emfcamp/Mk2-Hardware/README.md

Hardware
========

Hardware for the TiLDA v2 Badge
