emfcamp/Mk2-Hardware/TiLDA Mk2 Prototype v0.333 Schematic.pdf

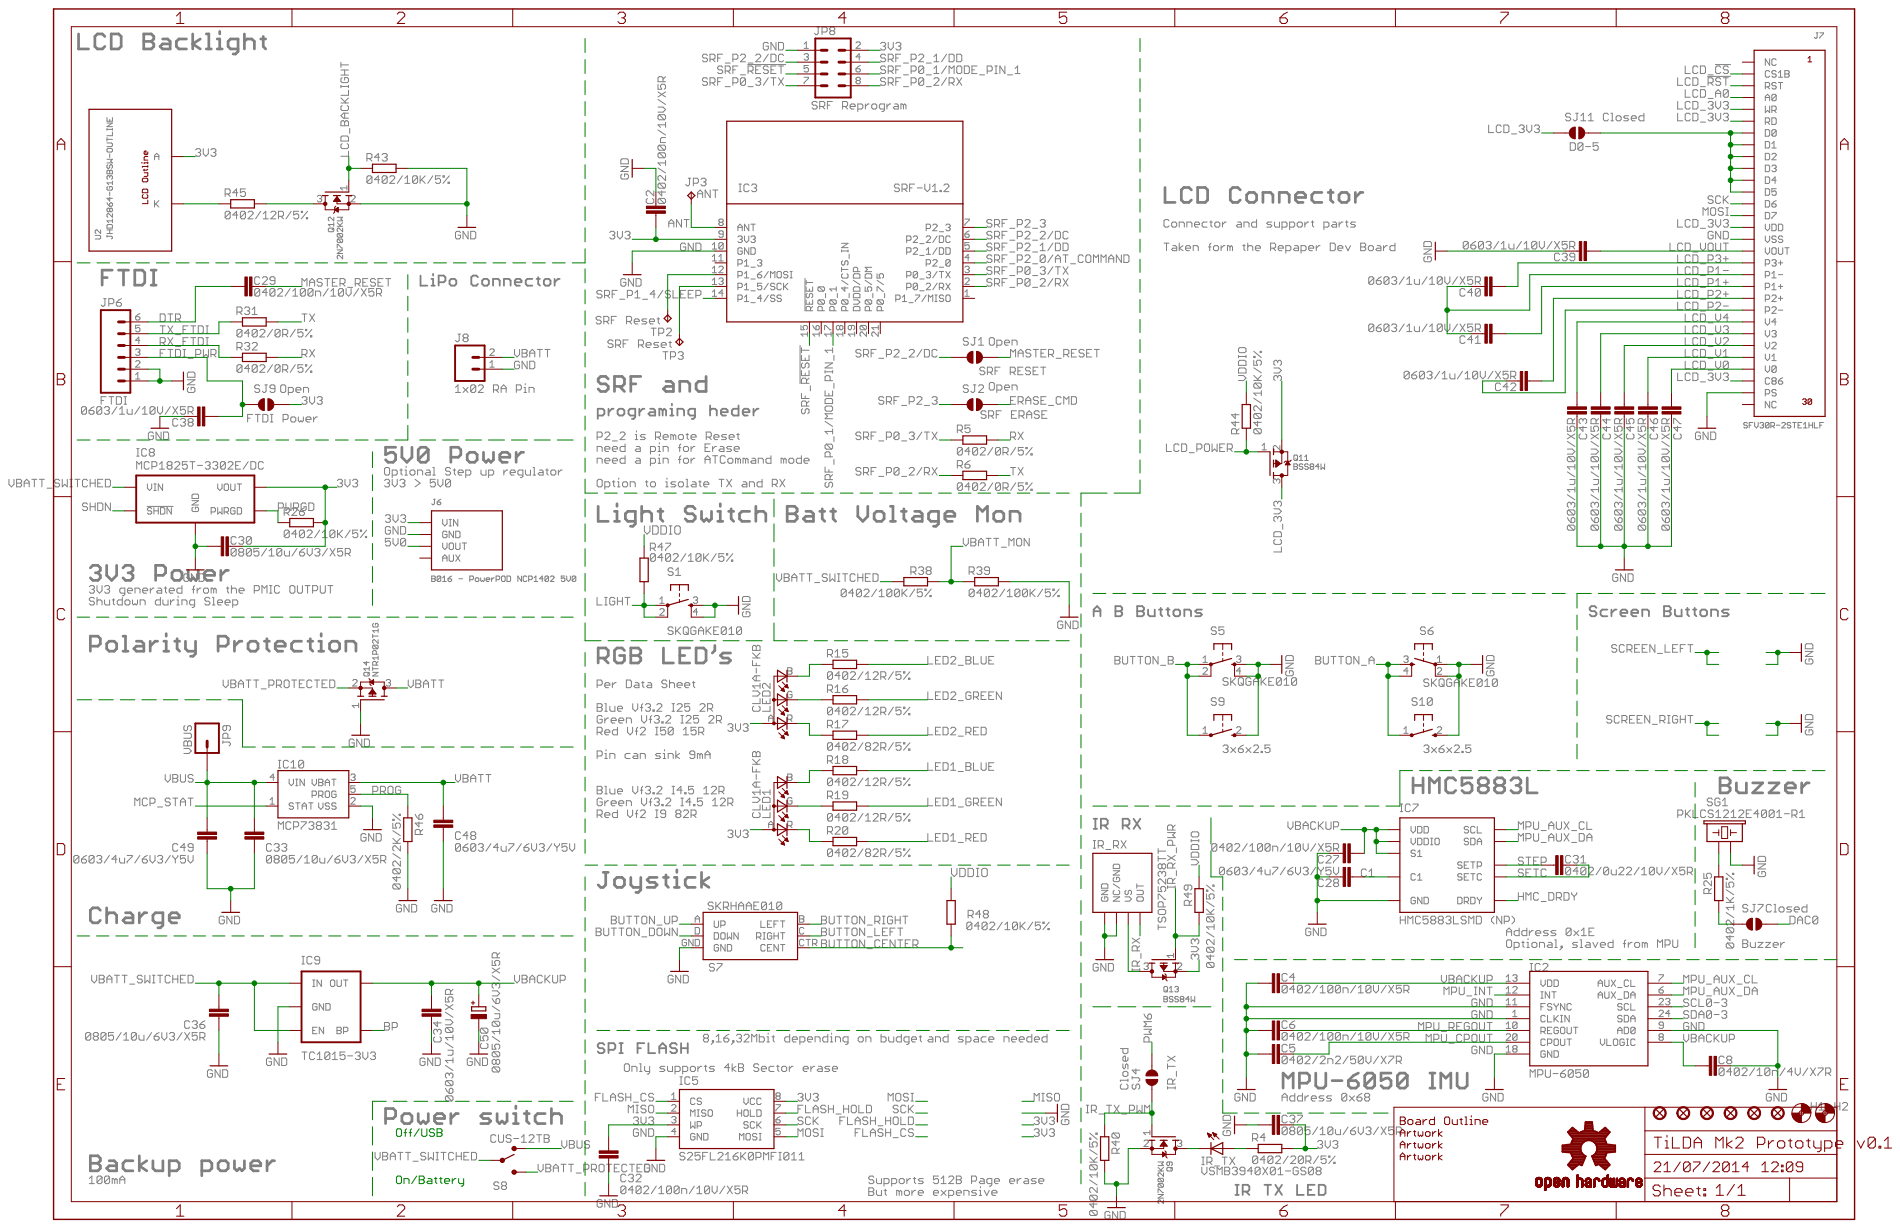
[picture p1: page 1]

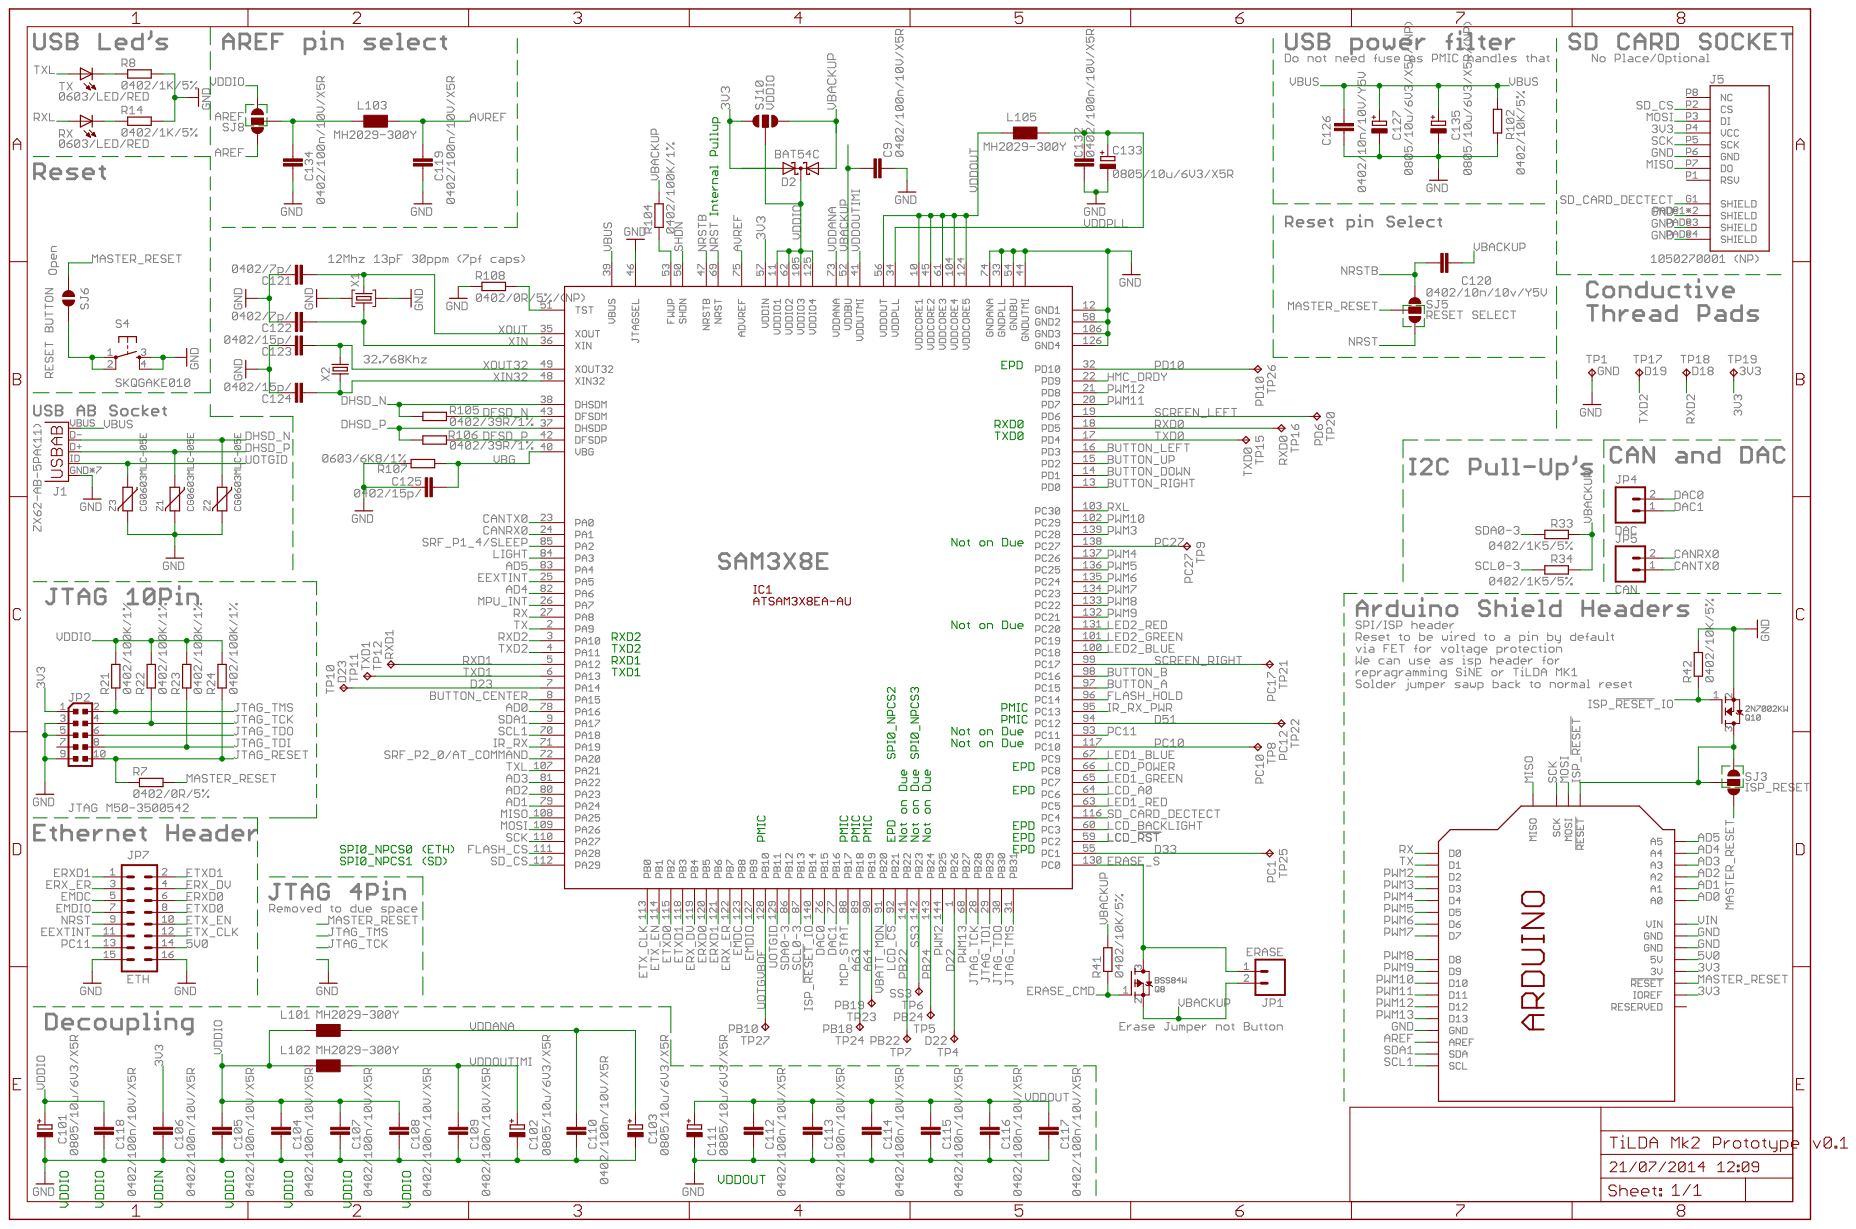
[picture p2: page 2]

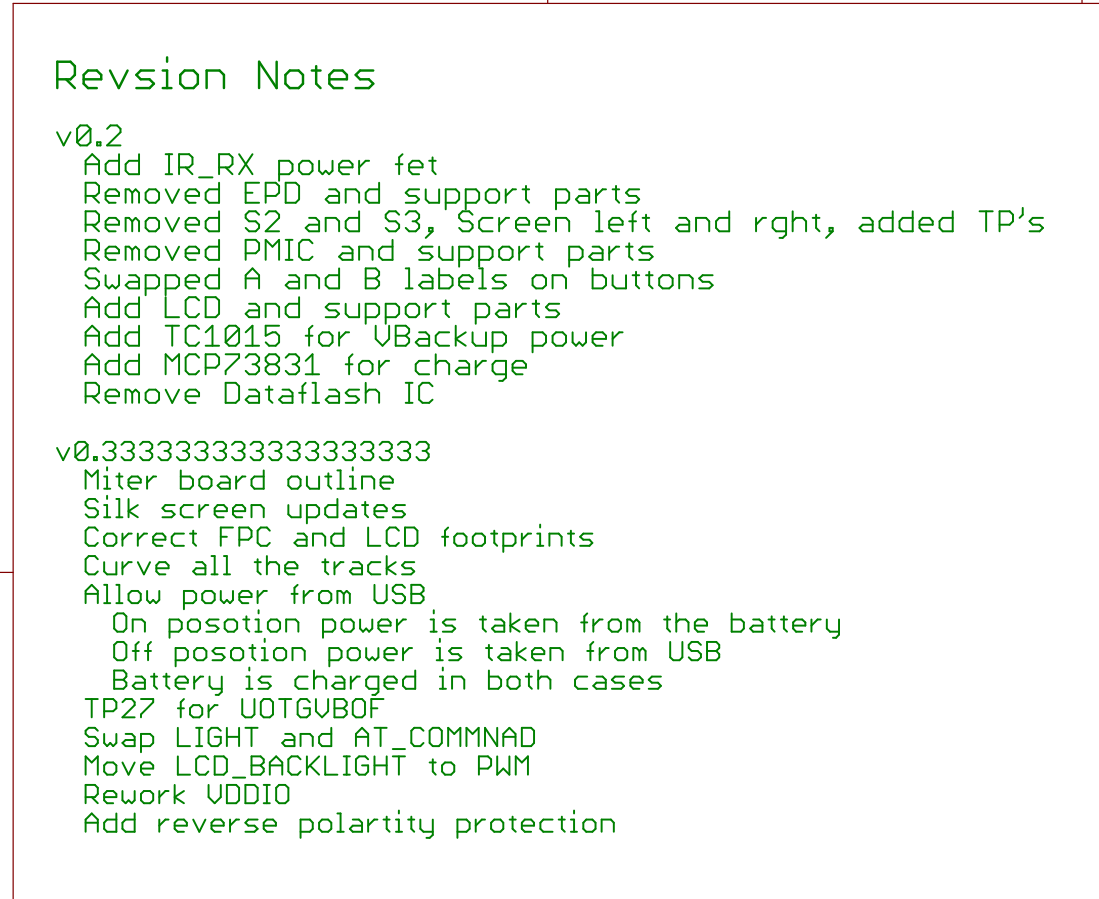
[picture p3: page 3]
