emfcamp/Mk2-Hardware/TiLDA Mk2 Prototype v0.2 Schematic.pdf

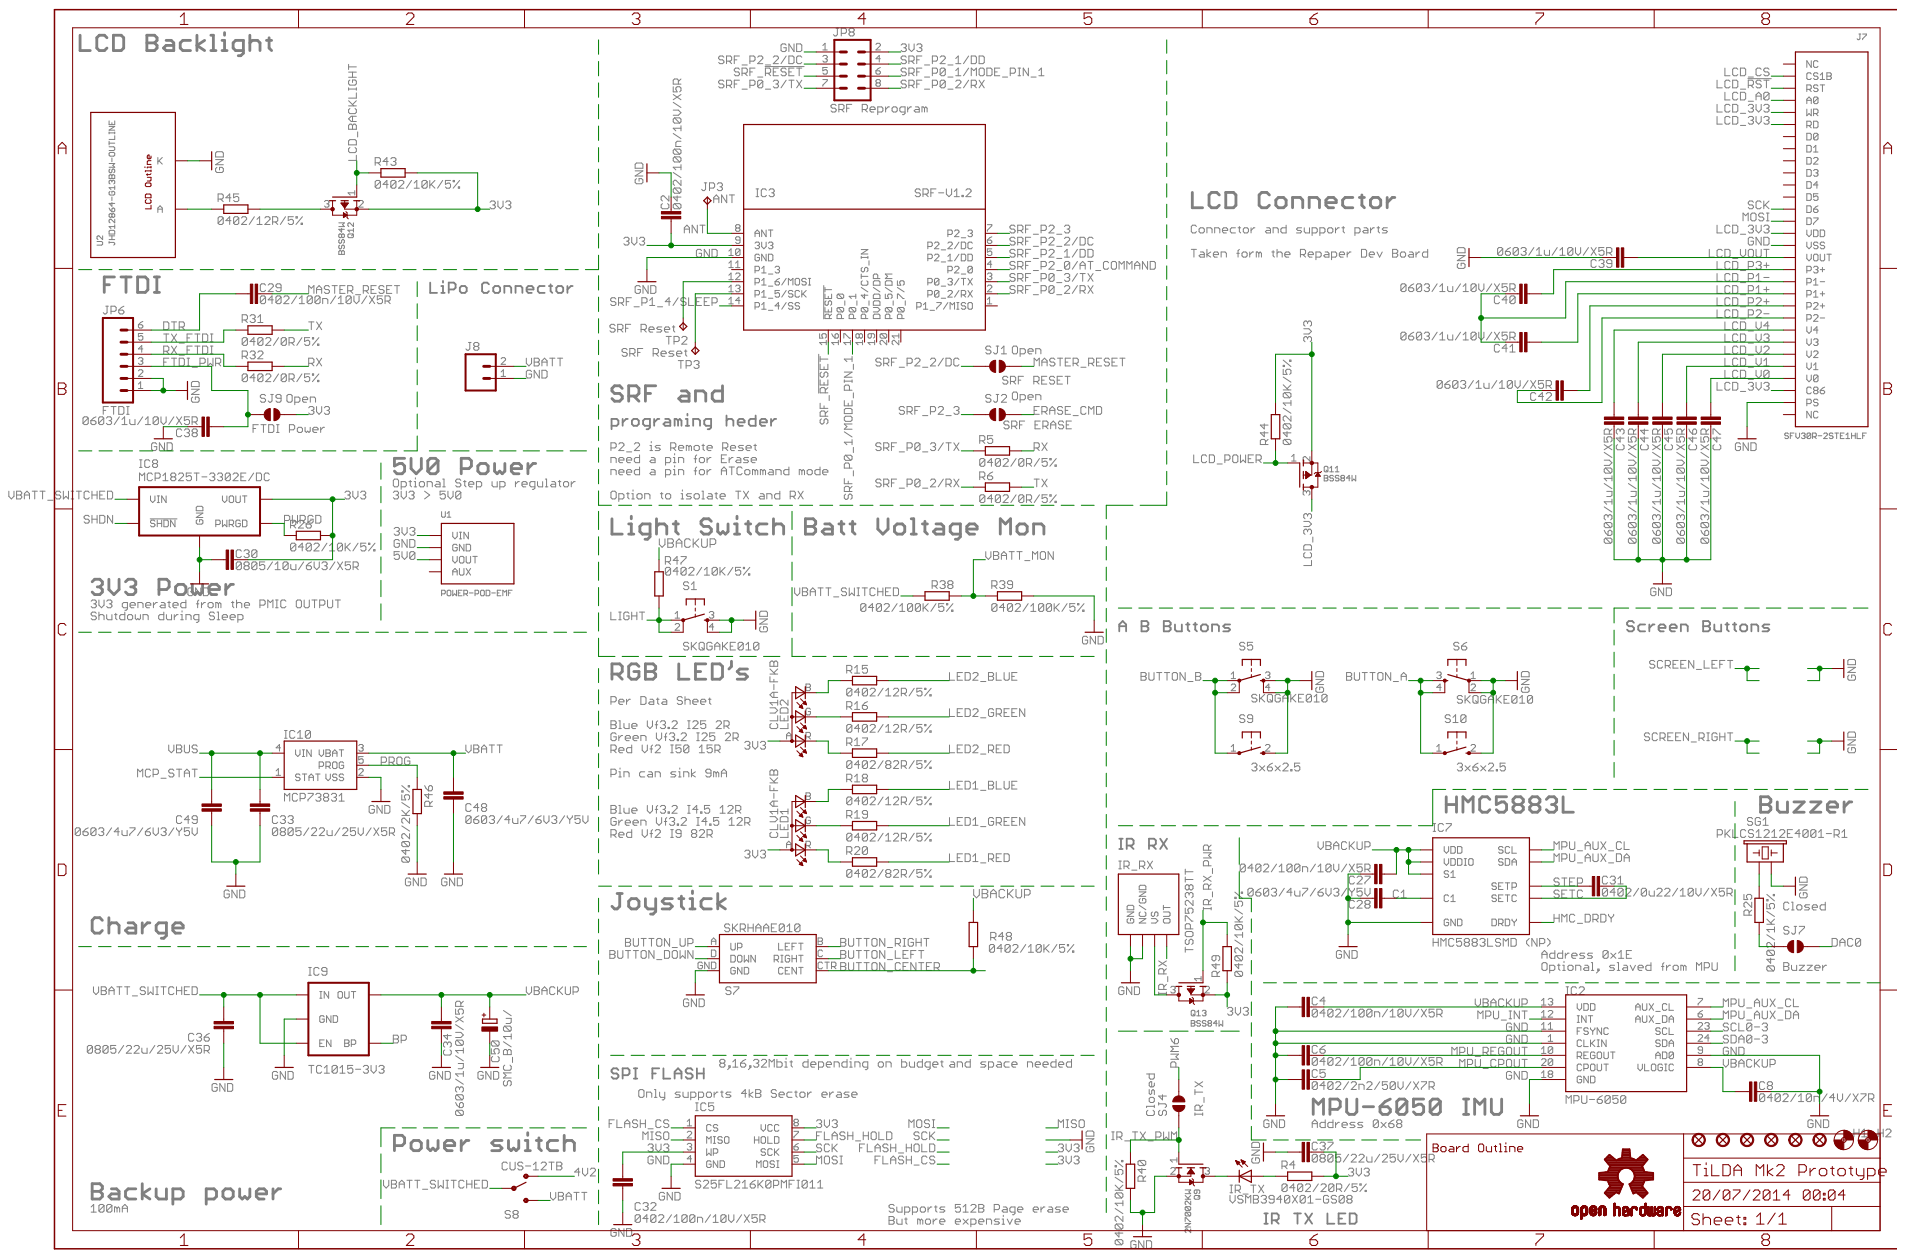
[picture p4: page 1]

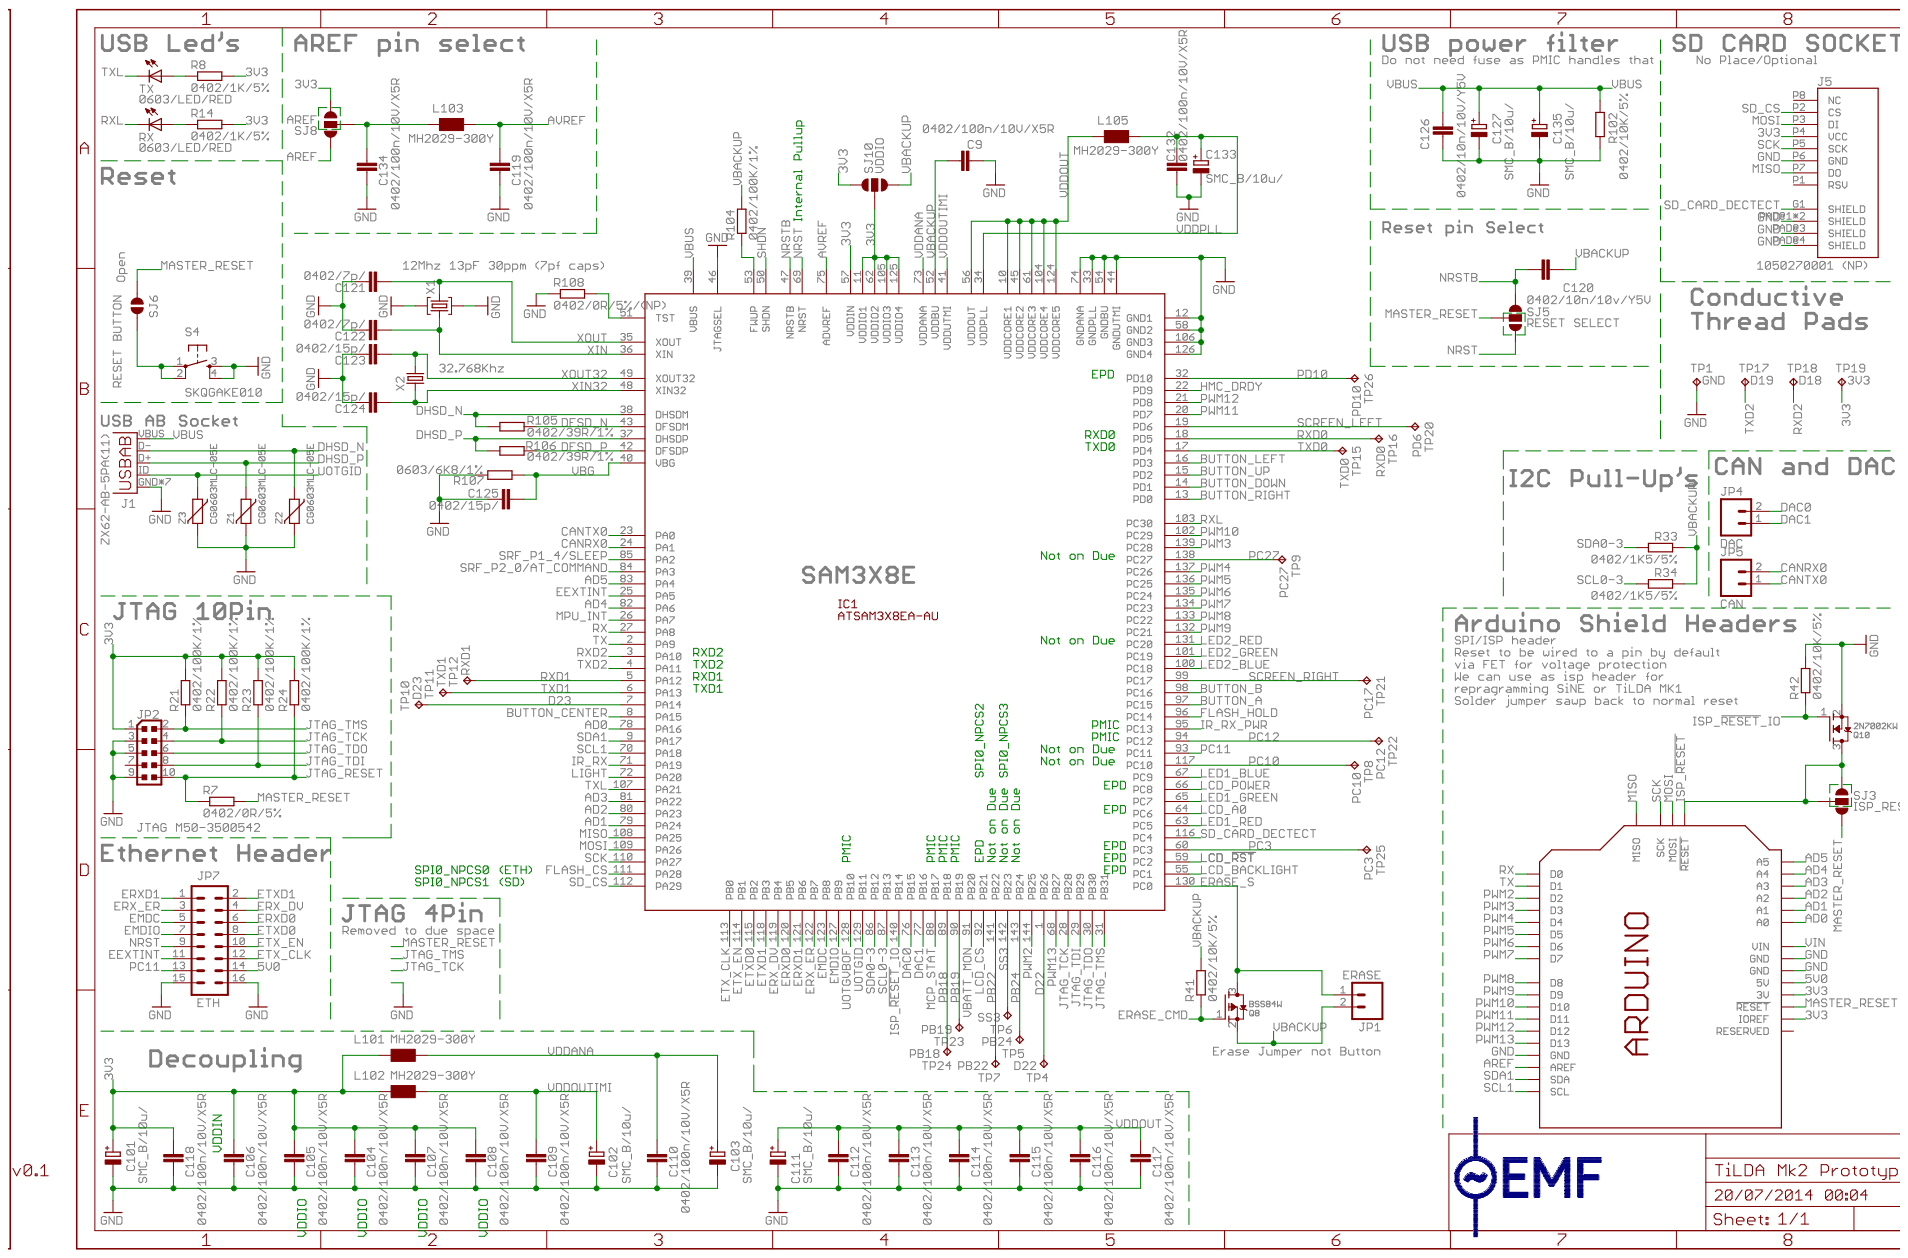
[picture p5: page 2]

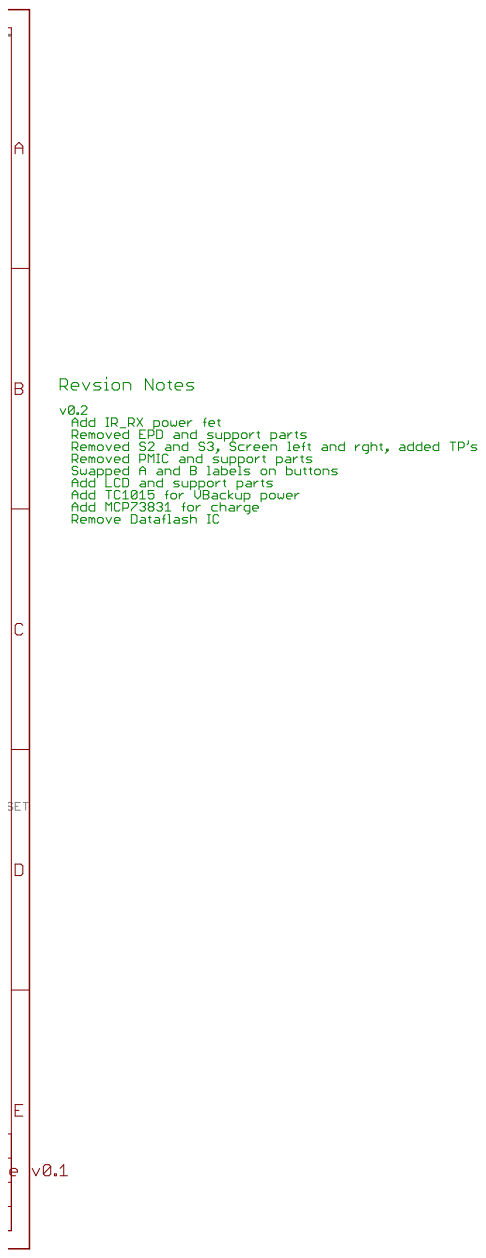
[picture p6: page 3]
