emfcamp/Mk2-Hardware/TiLDA Mk2 Prototype v0.1 Schematic.pdf

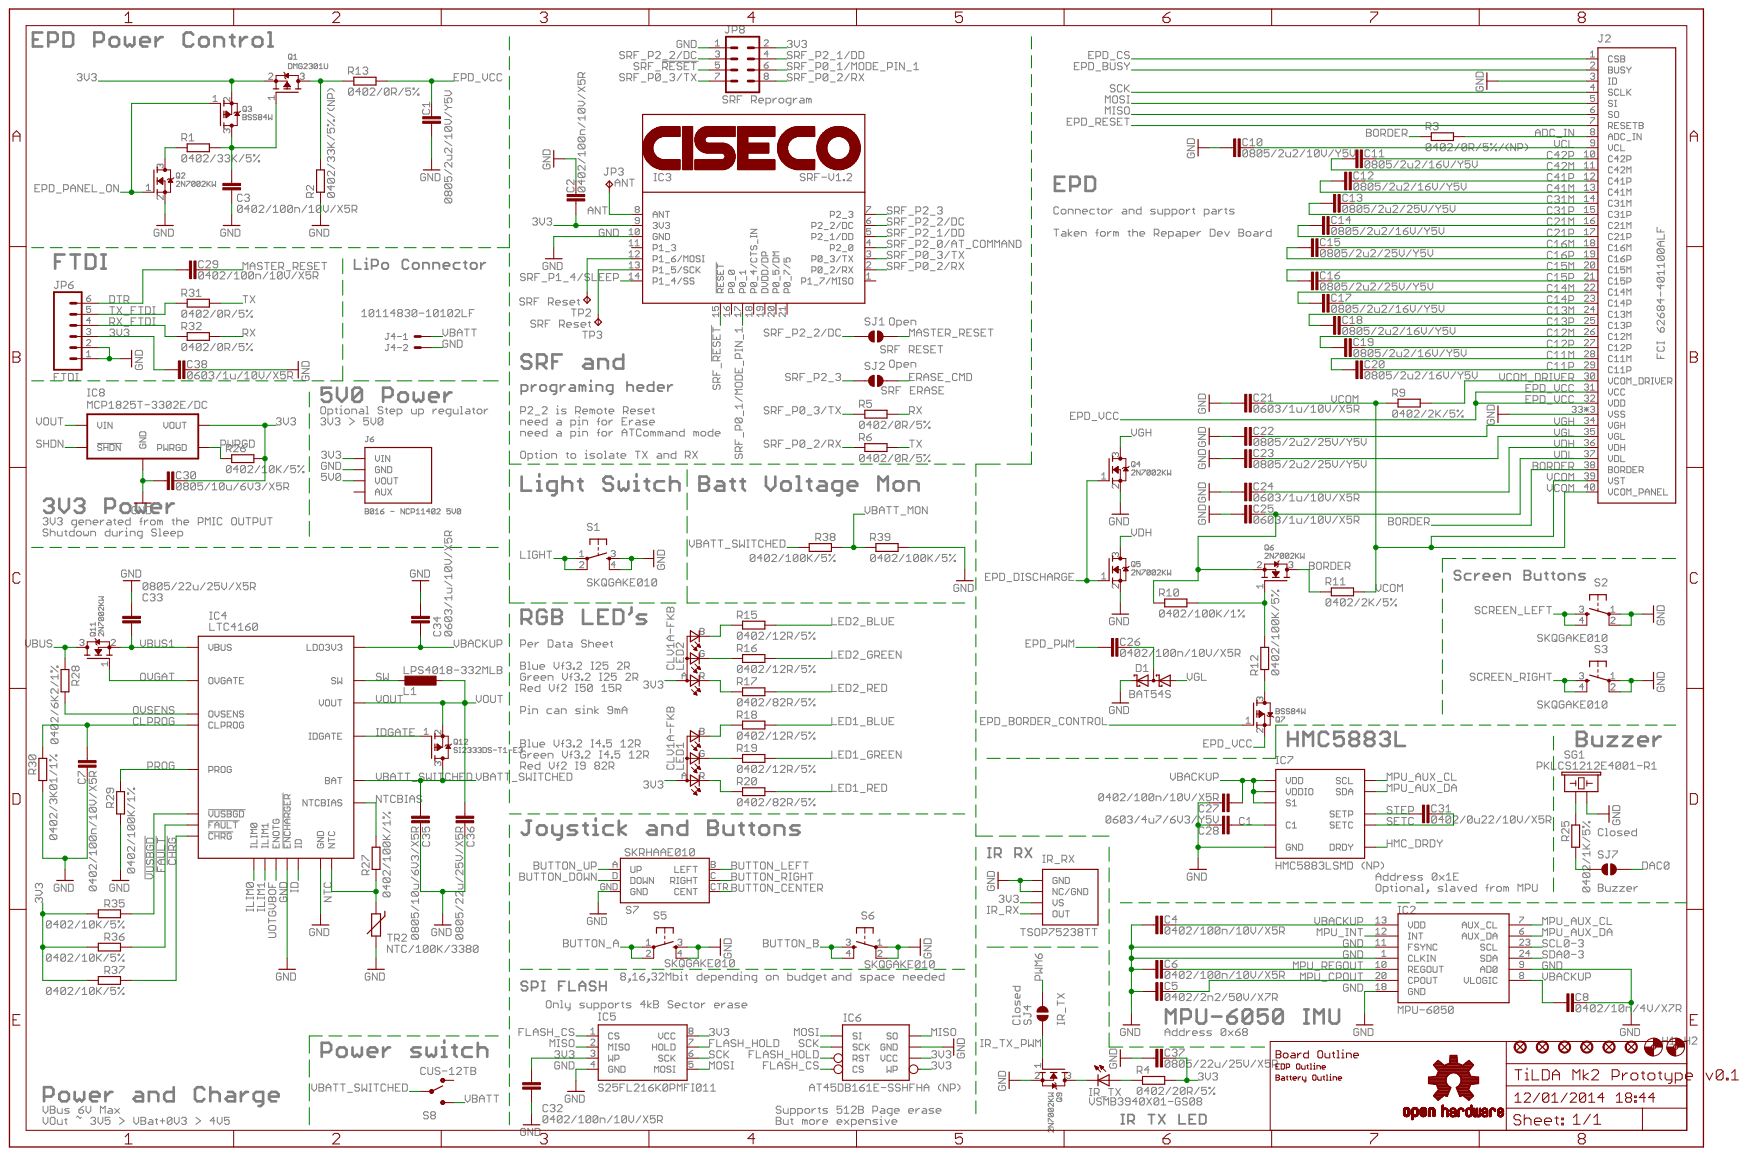
[picture p7: page 1]

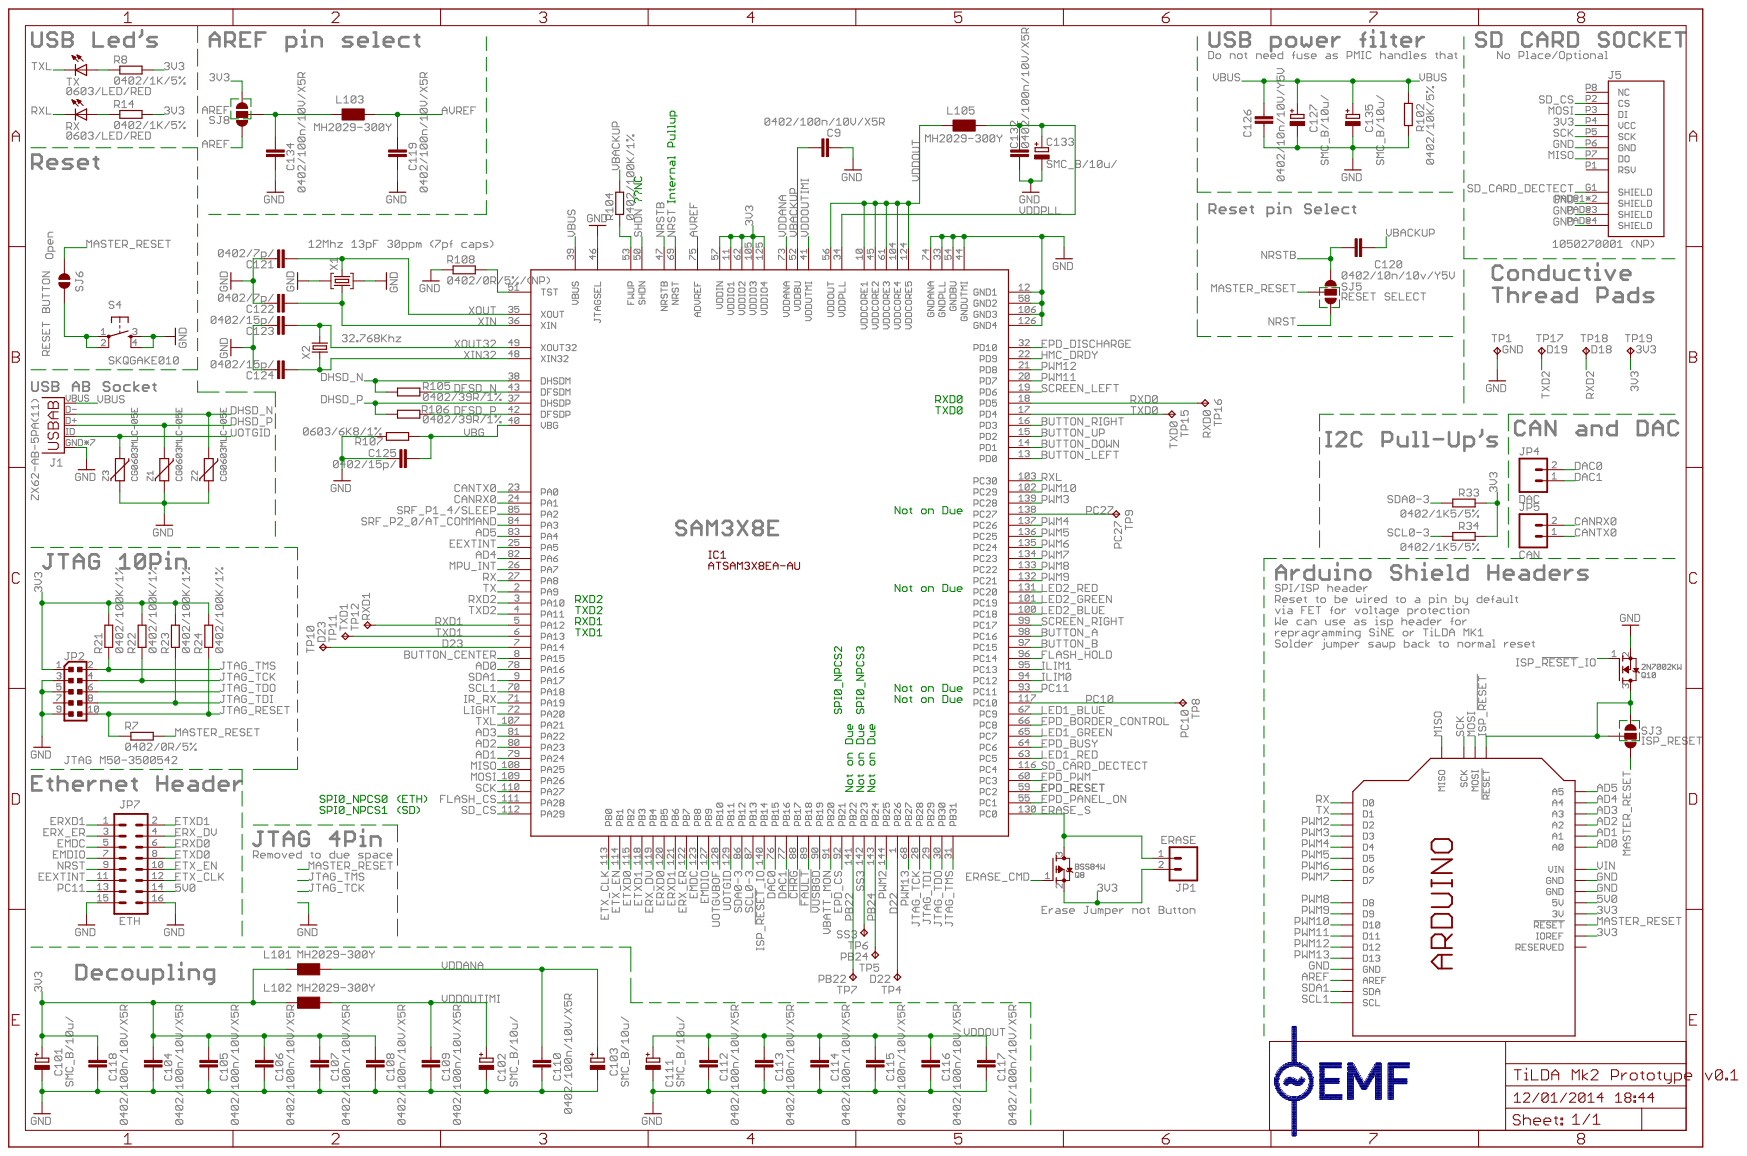
[picture p8: page 2]
