emfcamp/Mk2-Hardware/TiLDA Mk2 Prototype v0.333.pdf

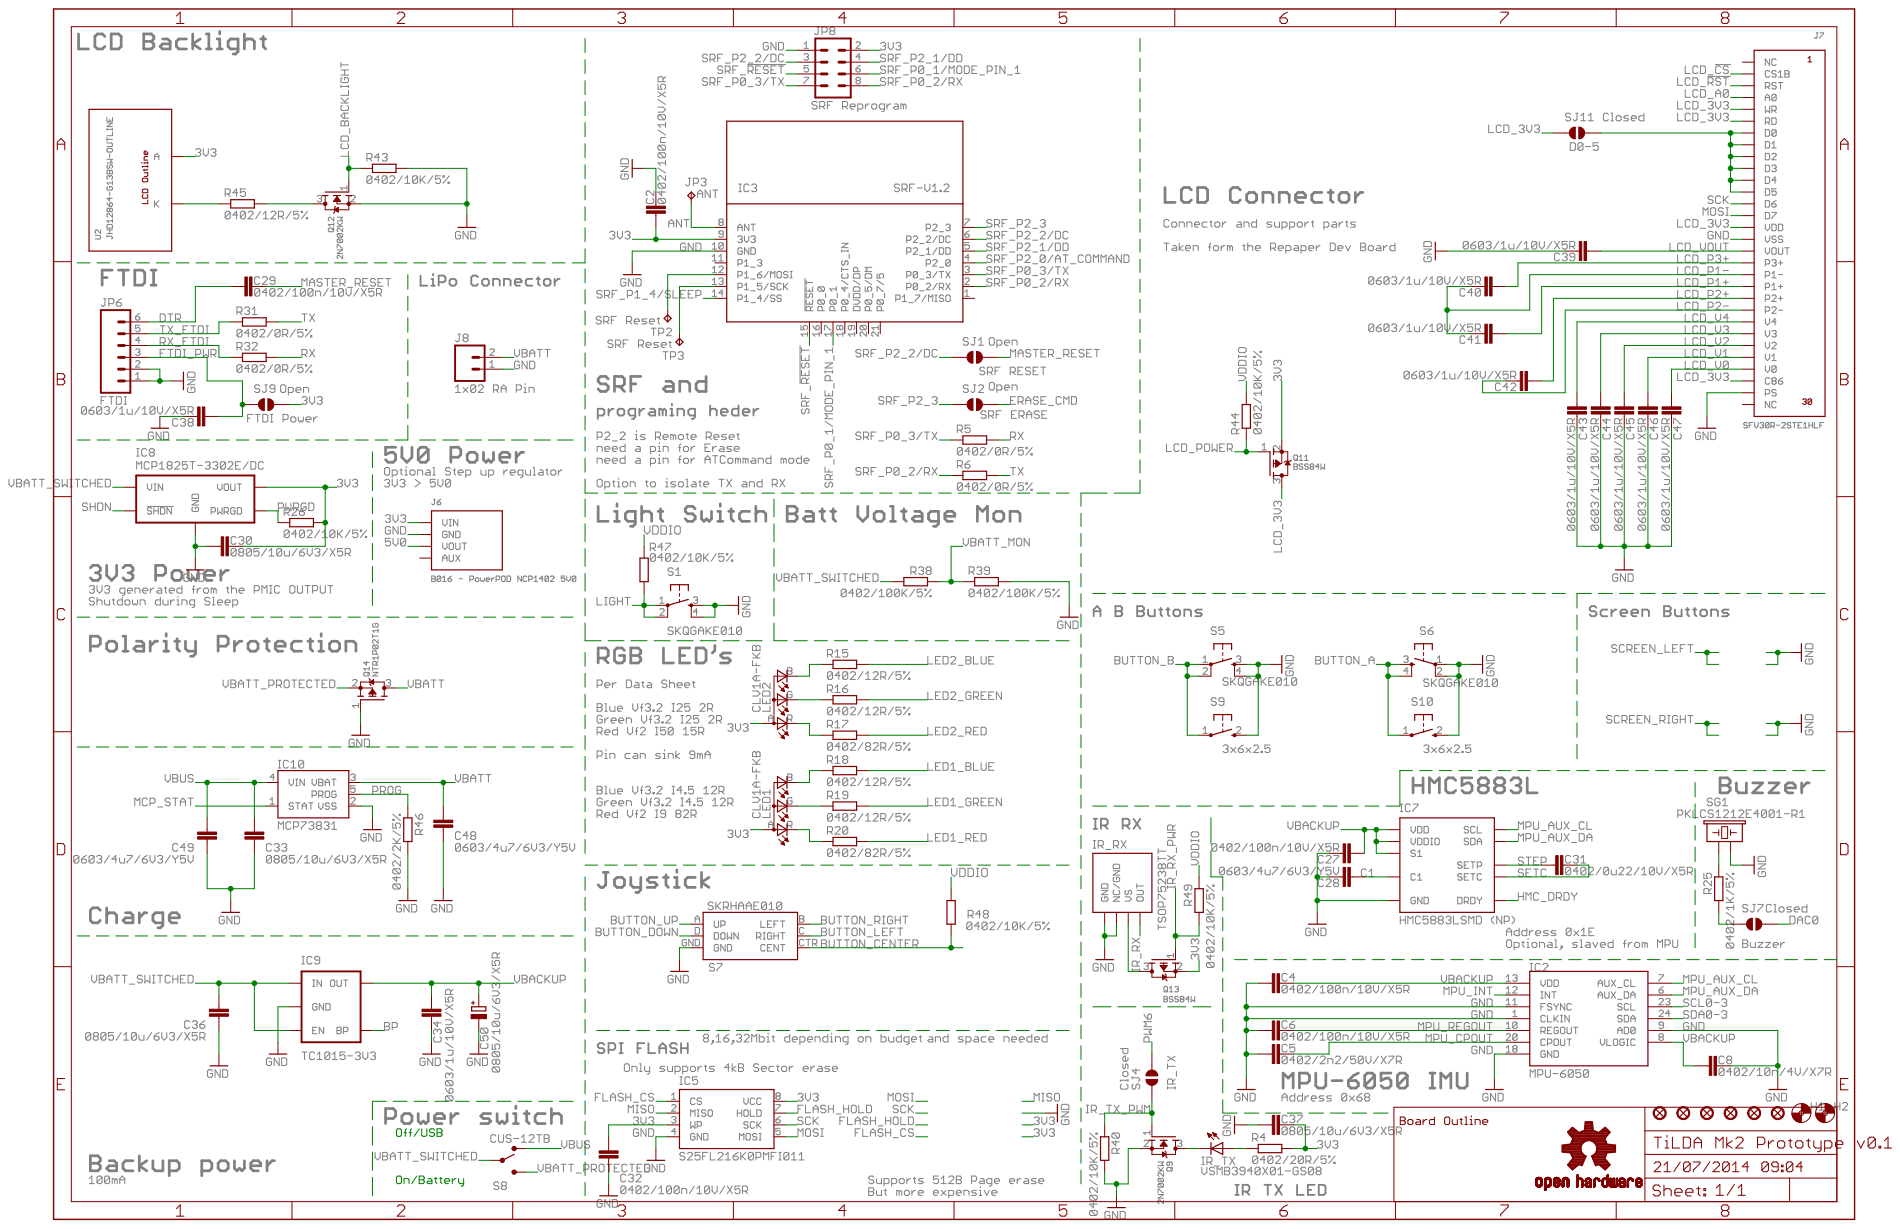
[picture p9: page 1]

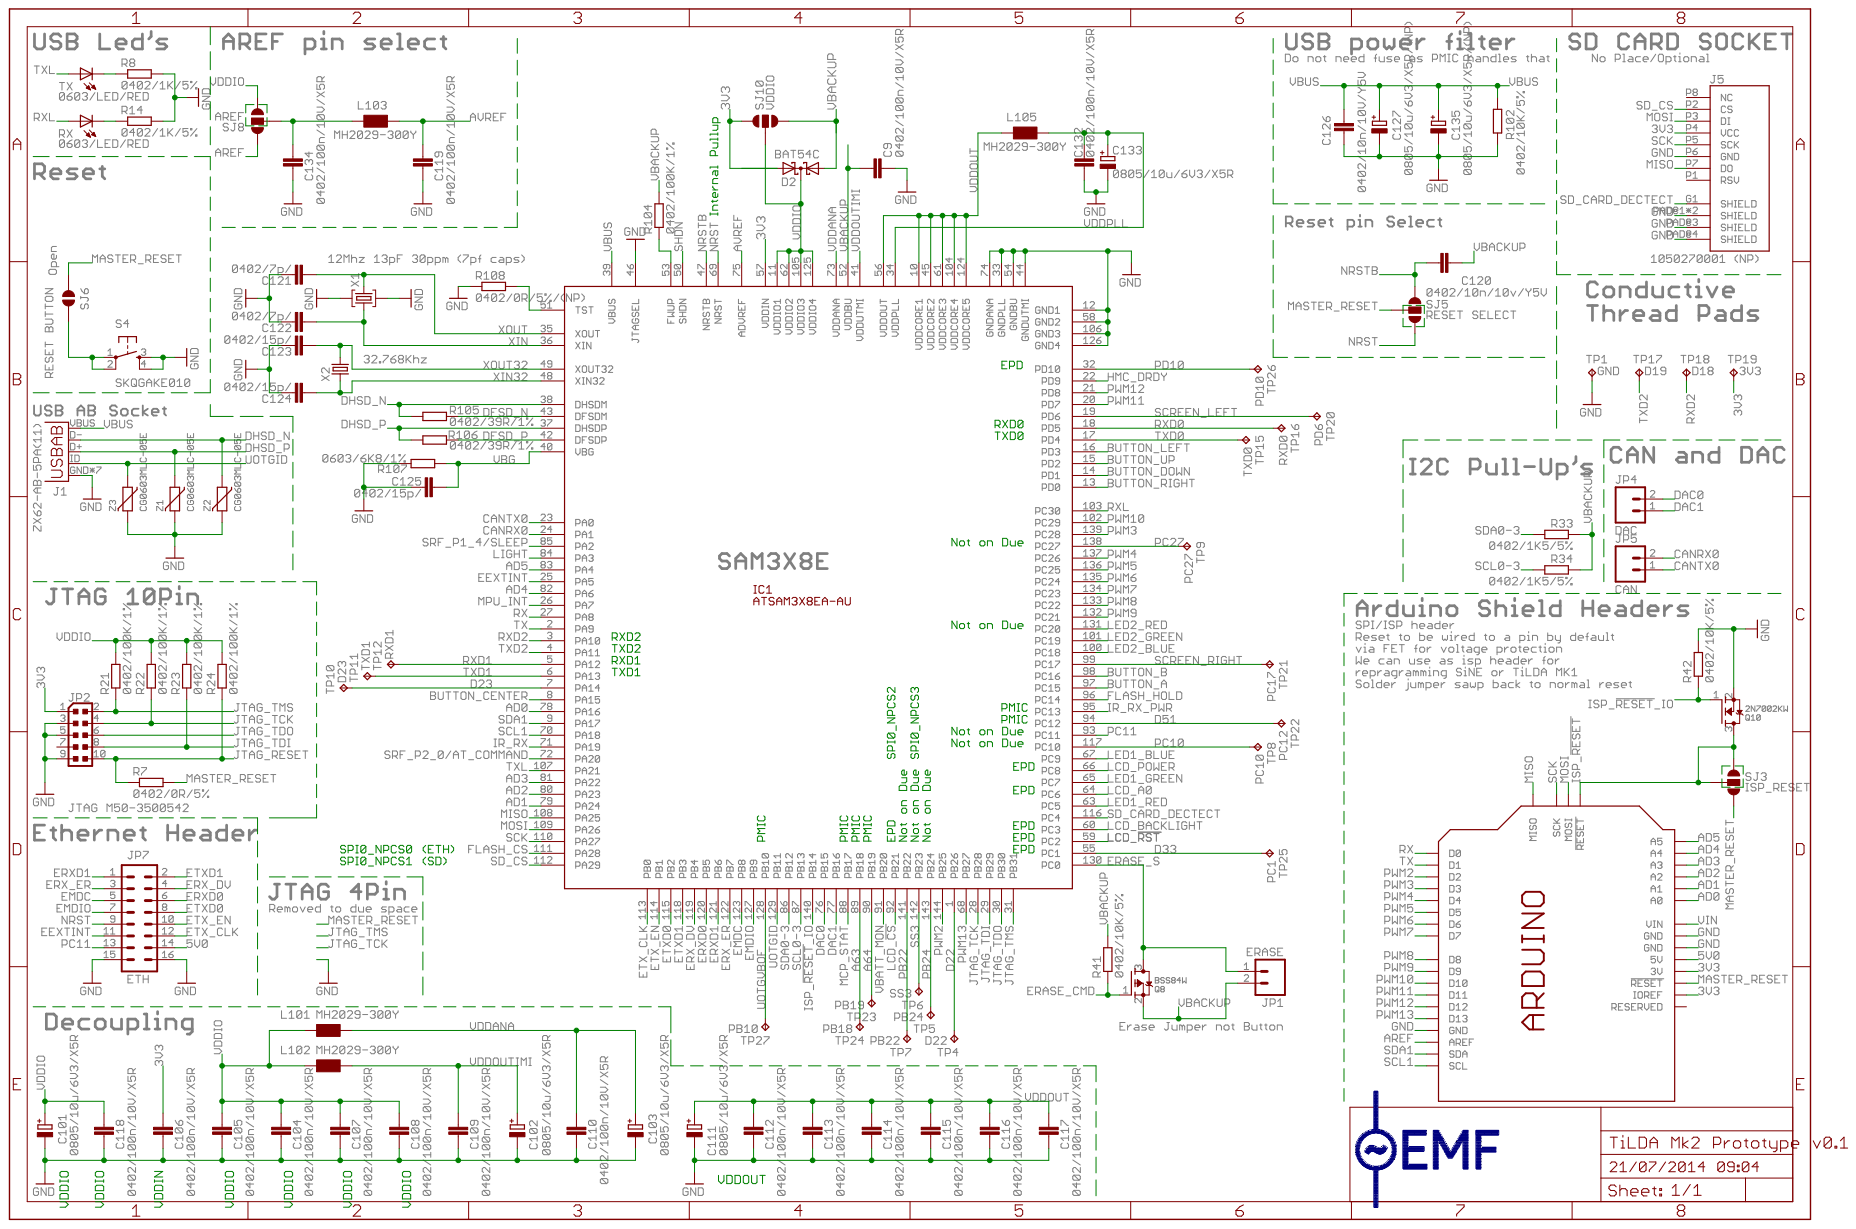
[picture p10: page 2]
