emfcamp/Mk2-Hardware/TiLDA Mk2 ProtoShield v0.1.brd

## EAGLE design TiLDA Mk2 ProtoShield v0.1.brd (2015-05-13)

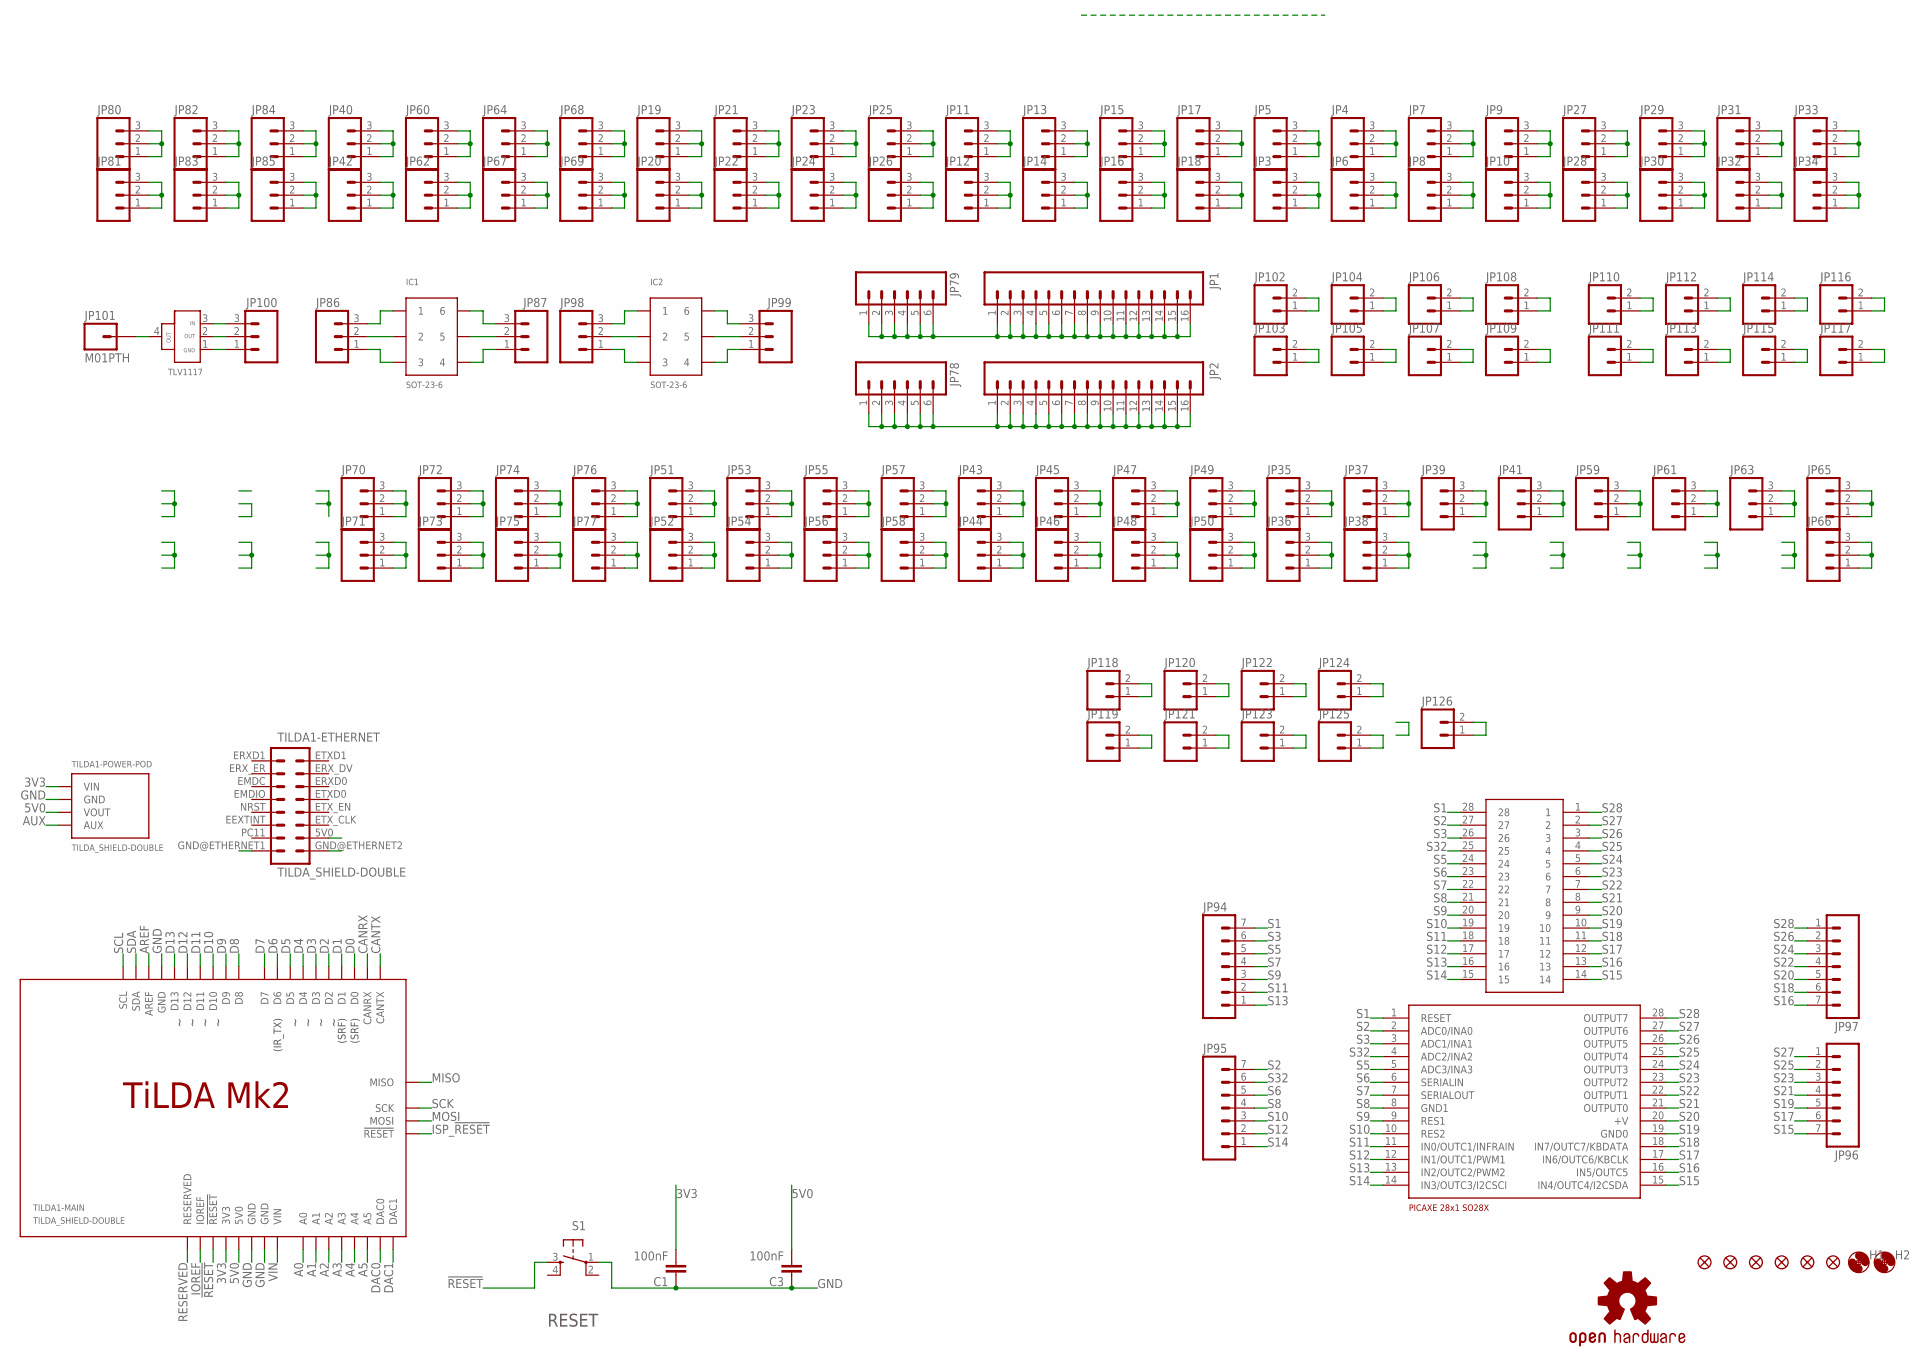
[picture p11: schematic TiLDA Mk2 ProtoShield v0.1.sch]

Parts:
C1, C3: 100nF; C025-024X044
FID1, FID2, FID3, FID4, FID5, FID6: FIDUCIAL1X2.5-STOP; FIDUCIAL-1X2.5-STOP
H1, H2: MOUNT-HOLE4.5-LWK; 4,5-LWK
IC1, IC2: SOT-23-6
JP1, JP2: M16PROTO_SILK; 1X16_PROTO_SILK
JP3, JP4, JP5, JP6, JP7, JP8, JP9, JP10, JP11, JP12, JP13, JP14, JP15, JP16, JP17, JP18, JP19, JP20, JP21, JP22, JP23, JP24, JP25, JP26, JP27, JP28, JP29, JP30, JP31, JP32, JP33, JP34, JP35, JP36, JP37, JP38, JP39, JP40, JP41, JP42, JP43, JP44, JP45, JP46, JP47, JP48, JP49, JP50, JP51, JP52, JP53, JP54, JP55, JP56, JP57, JP58, JP59, JP60, JP61, JP62, JP63, JP64, JP65, JP66, JP67, JP68, JP69, JP70, JP71, JP72, JP73, JP74, JP75, JP76, JP77, JP80, JP81, JP82, JP83, JP84, JP85: M03PROTO_SILK; 1X03_PROTO_SILK
JP78, JP79: M06PROTO_SILK; 1X06_PROTO_SLIK
JP86, JP87, JP98, JP99, JP100: M03PTH; 1X03
JP94, JP95, JP96, JP97: M07; 1X07
JP101: M01PTH; 1X01
JP102, JP103, JP104, JP105, JP106, JP107, JP108, JP109, JP110, JP111, JP112, JP113, JP114, JP115, JP116, JP117, JP118, JP119, JP120, JP121, JP122, JP123, JP124, JP125, JP126: M02PROTO_SILK; 1X02_PROTO_SILK
LOGO1: OSHW-LOGOM; OSHW-LOGO-M
LOGO2: EMFLOGO-2014-BOTH; EMFLOGO4
S1: TAC_SWITCHPTH; TACTILE-PTH
TILDA1: TILDA_SHIELD-DOUBLE; TILDA_SHIELD_DOUBLE
U$1: TLV1117-33CDCY; SOT223
U$2: SSOP28-NOSLIK; SSOP28D-NOSILK
U$5: PICAXE-28X1-SO28-MULITWIDE; S028-MUTLIWIDE

Connections:
3V3: C1.2, TILDA1.3V3@1 (3V3), TILDA1.3V3@2 (3V3), TILDA1.3V3@POD (VIN), TILDA1.3V3@POD1 (VIN)
5V0: C3.2, TILDA1.5V (5V0), TILDA1.5V0 (14), TILDA1.5V0@1 (5V0), TILDA1.5V0@POD (VOUT), TILDA1.5V0@POD1 (VOUT), TILDA1.5V@ISP (5V0), TILDA1.5V@ISP@1 (5V0)
!RESET: S1.3, TILDA1.!RESET, TILDA1.!RESET@1 (!RESET)
A0: TILDA1.A0, TILDA1.A0@1 (A0)
A1: TILDA1.A1, TILDA1.A1@1 (A1)
A2: TILDA1.A2, TILDA1.A2@1 (A2)
A3: TILDA1.A3, TILDA1.A3@1 (A3)
A4: TILDA1.A4, TILDA1.A4@1 (A4)
A5: TILDA1.A5, TILDA1.A5@1 (A5)
AREF: TILDA1.AREF, TILDA1.AREF@1 (AREF)
AUX: TILDA1.AUX@POD (AUX), TILDA1.AUX@POD1 (AUX)
CANRX: TILDA1.CANRX, TILDA1.CANRX@1 (CANRX)
CANTX: TILDA1.CANTX, TILDA1.CANTX@1 (CANTX)
D0: TILDA1.D0, TILDA1.D0@1 (D0)
D1: TILDA1.D1, TILDA1.D1@1 (D1)
D2: TILDA1.D2, TILDA1.D2@1 (D2)
D3: TILDA1.D3, TILDA1.D3@1 (D3)
D4: TILDA1.D4, TILDA1.D4@1 (D4)
D5: TILDA1.D5, TILDA1.D5@1 (D5)
D6: TILDA1.D6, TILDA1.D6@1 (D6)
D7: TILDA1.D7, TILDA1.D7@1 (D7)
D8: TILDA1.D8, TILDA1.D8@1 (D8)
D9: TILDA1.D9, TILDA1.D9@1 (D9)
D10: TILDA1.D10, TILDA1.D10@1 (D10)
D11: TILDA1.D11, TILDA1.D11@1 (D11)
D12: TILDA1.D12, TILDA1.D12@1 (D12)
D13: TILDA1.D13, TILDA1.D13@1 (D13)
DAC0: TILDA1.DAC0, TILDA1.DAC0@1 (DAC0)
DAC1: TILDA1.DAC1, TILDA1.DAC1@1 (DAC1)
GND: C1.1, C3.1, S1.1, TILDA1.GND@1 (GND), TILDA1.GND@2 (GND), TILDA1.GND@3 (GND), TILDA1.GND@4 (GND), TILDA1.GND@5 (GND), TILDA1.GND@6 (GND), TILDA1.GND@ETHERNET1 (15), TILDA1.GND@ETHERNET2 (16), TILDA1.GND@ISP (GND), TILDA1.GND@ISP1 (GND), TILDA1.GND@POD (GND), TILDA1.GND@POD1 (GND)
IOREF: TILDA1.IOREF, TILDA1.IOREF@1 (IOREF)
ISP_!RESET: TILDA1.!RESET@ISP (!RESET), TILDA1.!RESET@ISP1 (!RESET)
MISO: TILDA1.MISO, TILDA1.MISO@1 (MISO)
MOSI: TILDA1.MOSI, TILDA1.MOSI@1 (MOSI)
unnamed: JP1.1, JP1.2, JP1.3, JP1.4, JP1.5, JP1.6, JP1.7, JP1.8, JP1.9, JP1.10, JP1.11, JP1.12, JP1.13, JP1.14, JP1.15, JP1.16, JP79.1, JP79.2, JP79.3, JP79.4, JP79.5, JP79.6
unnamed: JP2.1, JP2.2, JP2.3, JP2.4, JP2.5, JP2.6, JP2.7, JP2.8, JP2.9, JP2.10, JP2.11, JP2.12, JP2.13, JP2.14, JP2.15, JP2.16, JP78.1, JP78.2, JP78.3, JP78.4, JP78.5, JP78.6
unnamed: JP5.1, JP5.2, JP5.3
unnamed: JP3.1, JP3.2, JP3.3
unnamed: JP4.1, JP4.2, JP4.3
unnamed: JP6.1, JP6.2, JP6.3
unnamed: JP7.1, JP7.2, JP7.3
unnamed: JP8.1, JP8.2, JP8.3
unnamed: JP9.1, JP9.2, JP9.3
unnamed: JP10.1, JP10.2, JP10.3
unnamed: JP11.1, JP11.2, JP11.3
unnamed: JP12.1, JP12.2, JP12.3
unnamed: JP13.1, JP13.2, JP13.3
unnamed: JP14.1, JP14.2, JP14.3
unnamed: JP15.1, JP15.2, JP15.3
unnamed: JP16.1, JP16.2, JP16.3
unnamed: JP17.1, JP17.2, JP17.3
unnamed: JP18.1, JP18.2, JP18.3
unnamed: JP19.1, JP19.2, JP19.3
unnamed: JP20.1, JP20.2, JP20.3
unnamed: JP21.1, JP21.2, JP21.3
unnamed: JP22.1, JP22.2, JP22.3
unnamed: JP23.1, JP23.2, JP23.3
unnamed: JP24.1, JP24.2, JP24.3
unnamed: JP25.1, JP25.2, JP25.3
unnamed: JP26.1, JP26.2, JP26.3
unnamed: JP27.1, JP27.2, JP27.3
unnamed: JP28.1, JP28.2, JP28.3
unnamed: JP29.1, JP29.2, JP29.3
unnamed: JP30.1, JP30.2, JP30.3
unnamed: JP31.1, JP31.2, JP31.3
unnamed: JP32.1, JP32.2, JP32.3
unnamed: JP33.1, JP33.2, JP33.3
unnamed: JP34.1, JP34.2, JP34.3
unnamed: JP35.1, JP35.2, JP35.3
unnamed: JP36.1, JP36.2, JP36.3
unnamed: JP37.1, JP37.2, JP37.3
unnamed: JP38.1, JP38.2, JP38.3
unnamed: JP39.1, JP39.2, JP39.3
unnamed: JP41.1, JP41.2, JP41.3
unnamed: JP43.1, JP43.2, JP43.3
unnamed: JP44.1, JP44.2, JP44.3
unnamed: JP45.1, JP45.2, JP45.3
unnamed: JP46.1, JP46.2, JP46.3
unnamed: JP47.1, JP47.2, JP47.3
unnamed: JP48.1, JP48.2, JP48.3
unnamed: JP49.1, JP49.2, JP49.3
unnamed: JP50.1, JP50.2, JP50.3
unnamed: JP51.1, JP51.2, JP51.3
unnamed: JP52.1, JP52.2, JP52.3
unnamed: JP53.1, JP53.2, JP53.3
unnamed: JP54.1, JP54.2, JP54.3
unnamed: JP55.1, JP55.2, JP55.3
unnamed: JP56.1, JP56.2, JP56.3
unnamed: JP57.1, JP57.2, JP57.3
unnamed: JP58.1, JP58.2, JP58.3
unnamed: JP59.1, JP59.2, JP59.3
unnamed: JP61.1, JP61.2, JP61.3
unnamed: JP63.1, JP63.2, JP63.3
unnamed: JP65.1, JP65.2, JP65.3
unnamed: JP66.1, JP66.2, JP66.3
unnamed: JP40.1, JP40.2, JP40.3
unnamed: JP42.1, JP42.2, JP42.3
unnamed: JP60.1, JP60.2, JP60.3
unnamed: JP62.1, JP62.2, JP62.3
unnamed: JP64.1, JP64.2, JP64.3
unnamed: JP67.1, JP67.2, JP67.3
unnamed: JP68.1, JP68.2, JP68.3
unnamed: JP69.1, JP69.2, JP69.3
unnamed: JP70.1, JP70.2, JP70.3
unnamed: JP71.1, JP71.2, JP71.3
unnamed: JP72.1, JP72.2, JP72.3
unnamed: JP73.1, JP73.2, JP73.3
unnamed: JP74.1, JP74.2, JP74.3
unnamed: JP75.1, JP75.2, JP75.3
unnamed: JP76.1, JP76.2, JP76.3
unnamed: JP77.1, JP77.2, JP77.3
unnamed: IC1.2, JP86.2
unnamed: IC1.1, JP86.3
unnamed: JP80.1, JP80.2, JP80.3
unnamed: JP81.1, JP81.2, JP81.3
unnamed: JP82.1, JP82.2, JP82.3
unnamed: JP83.1, JP83.2, JP83.3
unnamed: JP84.1, JP84.2, JP84.3
unnamed: JP85.1, JP85.2, JP85.3
unnamed: IC1.3, JP86.1
unnamed: IC1.5, JP87.2
unnamed: IC1.6, JP87.3
unnamed: IC1.4, JP87.1
unnamed: IC2.2, JP98.2
unnamed: IC2.1, JP98.3
unnamed: IC2.3, JP98.1
unnamed: IC2.5, JP99.2
unnamed: IC2.6, JP99.3
unnamed: IC2.4, JP99.1
unnamed: JP100.1, U$1.1 (GND)
unnamed: JP100.2, U$1.2 (OUT1)
unnamed: JP100.3, U$1.3 (IN)
unnamed: JP101.1, U$1.4 (OUT2)
unnamed: JP102.1, JP102.2
unnamed: JP103.1, JP103.2
unnamed: JP104.1, JP104.2
unnamed: JP105.1, JP105.2
unnamed: JP106.1, JP106.2
unnamed: JP107.1, JP107.2
unnamed: JP108.1, JP108.2
unnamed: JP109.1, JP109.2
unnamed: JP110.1, JP110.2
unnamed: JP111.1, JP111.2
unnamed: JP112.1, JP112.2
unnamed: JP113.1, JP113.2
unnamed: JP114.1, JP114.2
unnamed: JP115.1, JP115.2
unnamed: JP116.1, JP116.2
unnamed: JP117.1, JP117.2
unnamed: JP118.1, JP118.2
unnamed: JP119.1, JP119.2
unnamed: JP120.1, JP120.2
unnamed: JP121.1, JP121.2
unnamed: JP122.1, JP122.2
unnamed: JP123.1, JP123.2
unnamed: JP124.1, JP124.2
unnamed: JP125.1, JP125.2
unnamed: JP126.1, JP126.2
RESERVED: TILDA1.RESERVED, TILDA1.RESERVED@1 (RESERVED)
S1: JP94.7, U$2.28, U$5.1 (RESET)
S2: JP95.7, U$2.27, U$5.2 (ADC0/INA0)
S3: JP94.6, U$2.26, U$5.3 (ADC1/INA1)
S5: JP94.5, U$2.24, U$5.5 (ADC3/INA3)
S6: JP95.5, U$2.23, U$5.6 (SERIALIN)
S7: JP94.4, U$2.22, U$5.7 (SERIALOUT)
S8: JP95.4, U$2.21, U$5.8 (GND1)
S9: JP94.3, U$2.20, U$5.9 (RES1)
S10: JP95.3, U$2.19, U$5.10 (RES2)
S11: JP94.2, U$2.18, U$5.11 (IN0/OUTC1/INFRAIN)
S12: JP95.2, U$2.17, U$5.12 (IN1/OUTC1/PWM1)
S13: JP94.1, U$2.16, U$5.13 (IN2/OUTC2/PWM2)
S14: JP95.1, U$2.15, U$5.14 (IN3/OUTC3/I2CSCI)
S15: JP96.7, U$2.14, U$5.15 (IN4/OUTC4/I2CSDA)
S16: JP97.7, U$2.13, U$5.16 (IN5/OUTC5)
S17: JP96.6, U$2.12, U$5.17 (IN6/OUTC6/KBCLK)
S18: JP97.6, U$2.11, U$5.18 (IN7/OUTC7/KBDATA)
S19: JP96.5, U$2.10, U$5.19 (GND0)
S20: JP97.5, U$2.9, U$5.20 (+V)
S21: JP96.4, U$2.8, U$5.21 (OUTPUT0)
S22: JP97.4, U$2.7, U$5.22 (OUTPUT1)
S23: JP96.3, U$2.6, U$5.23 (OUTPUT2)
S24: JP97.3, U$2.5, U$5.24 (OUTPUT3)
S25: JP96.2, U$2.4, U$5.25 (OUTPUT4)
S26: JP97.2, U$2.3, U$5.26 (OUTPUT5)
S27: JP96.1, U$2.2, U$5.27 (OUTPUT6)
S28: JP97.1, U$2.1, U$5.28 (OUTPUT7)
S32: JP95.6, U$2.25, U$5.4 (ADC2/INA2)
SCK: TILDA1.SCK, TILDA1.SCK@1 (SCK)
SCL: TILDA1.SCL, TILDA1.SCL@1 (SCL)
SDA: TILDA1.SDA, TILDA1.SDA@1 (SDA)
VIN: TILDA1.VIN, TILDA1.VIN@1 (VIN)

Notes on the sheet:
RESET

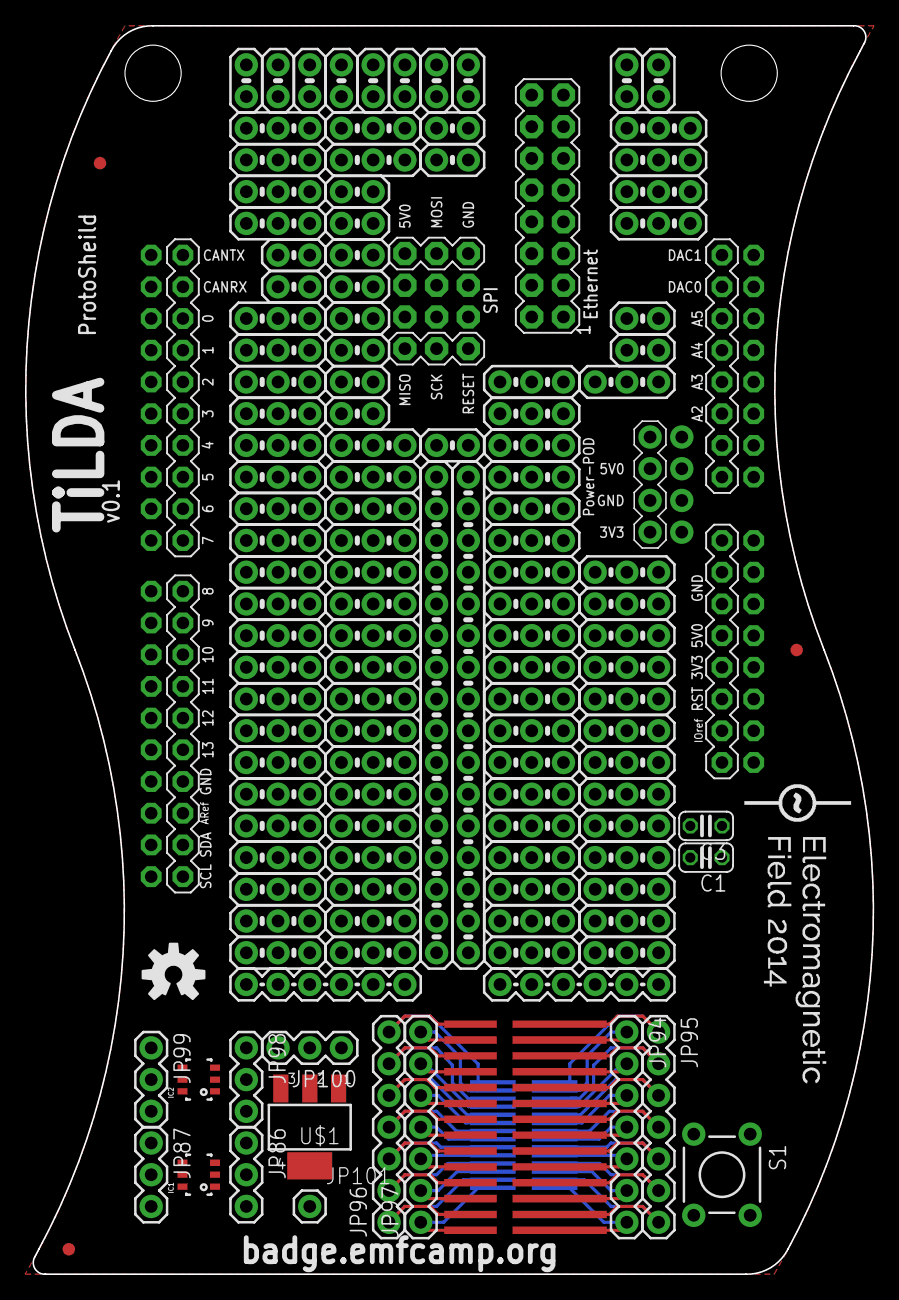
[picture p12: board TiLDA Mk2 ProtoShield v0.1.brd from above]

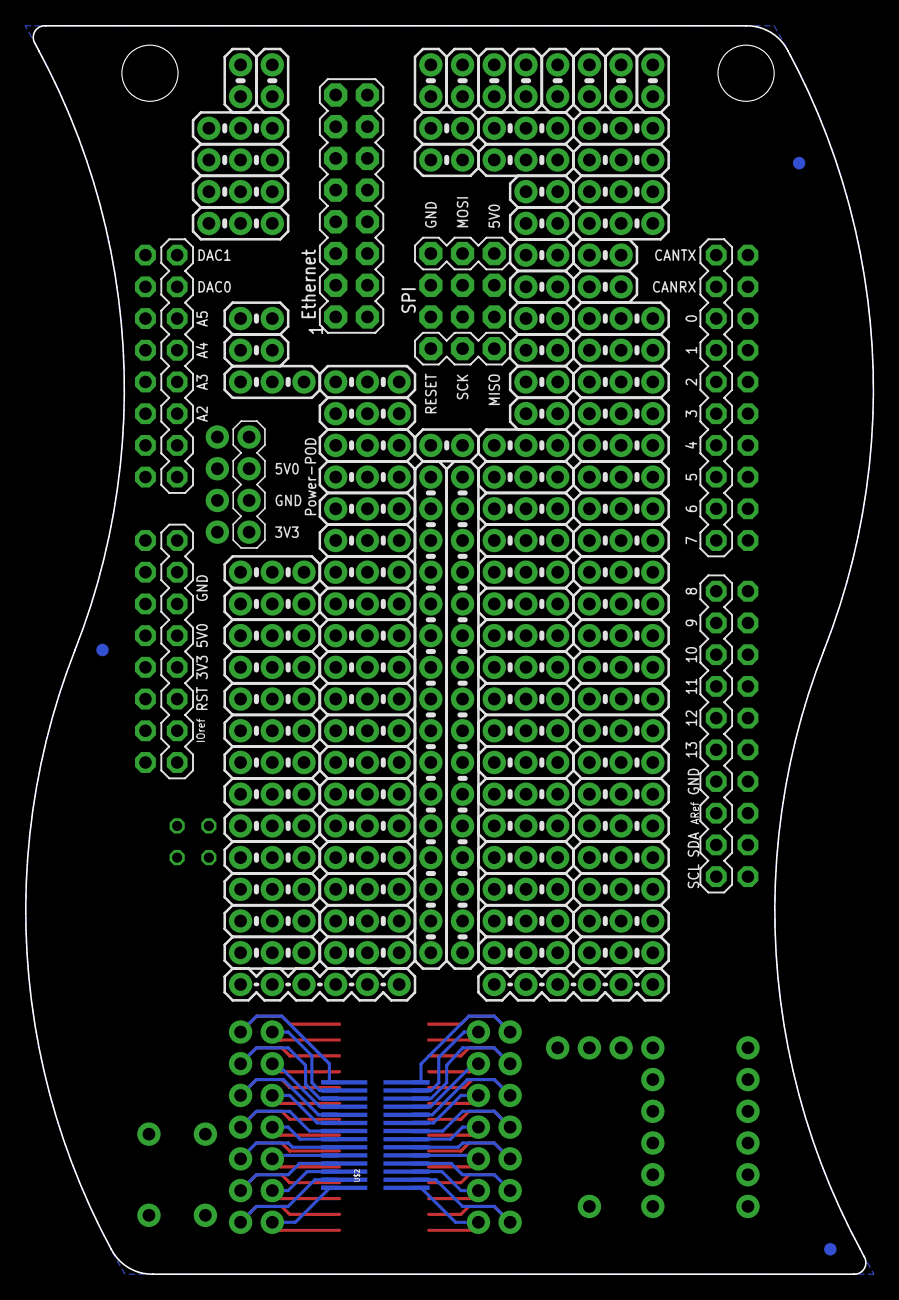
[picture p13: board TiLDA Mk2 ProtoShield v0.1.brd from below]

Board: 4 copper layers, 67.9 x 100.0 mm, 139 parts (4 on the bottom side), 191 nets.
