emfcamp/Mk2-Hardware/TiLDA Mk2 Prototype v0.1.brd

## EAGLE design TiLDA Mk2 Prototype v0.1.brd (continued)

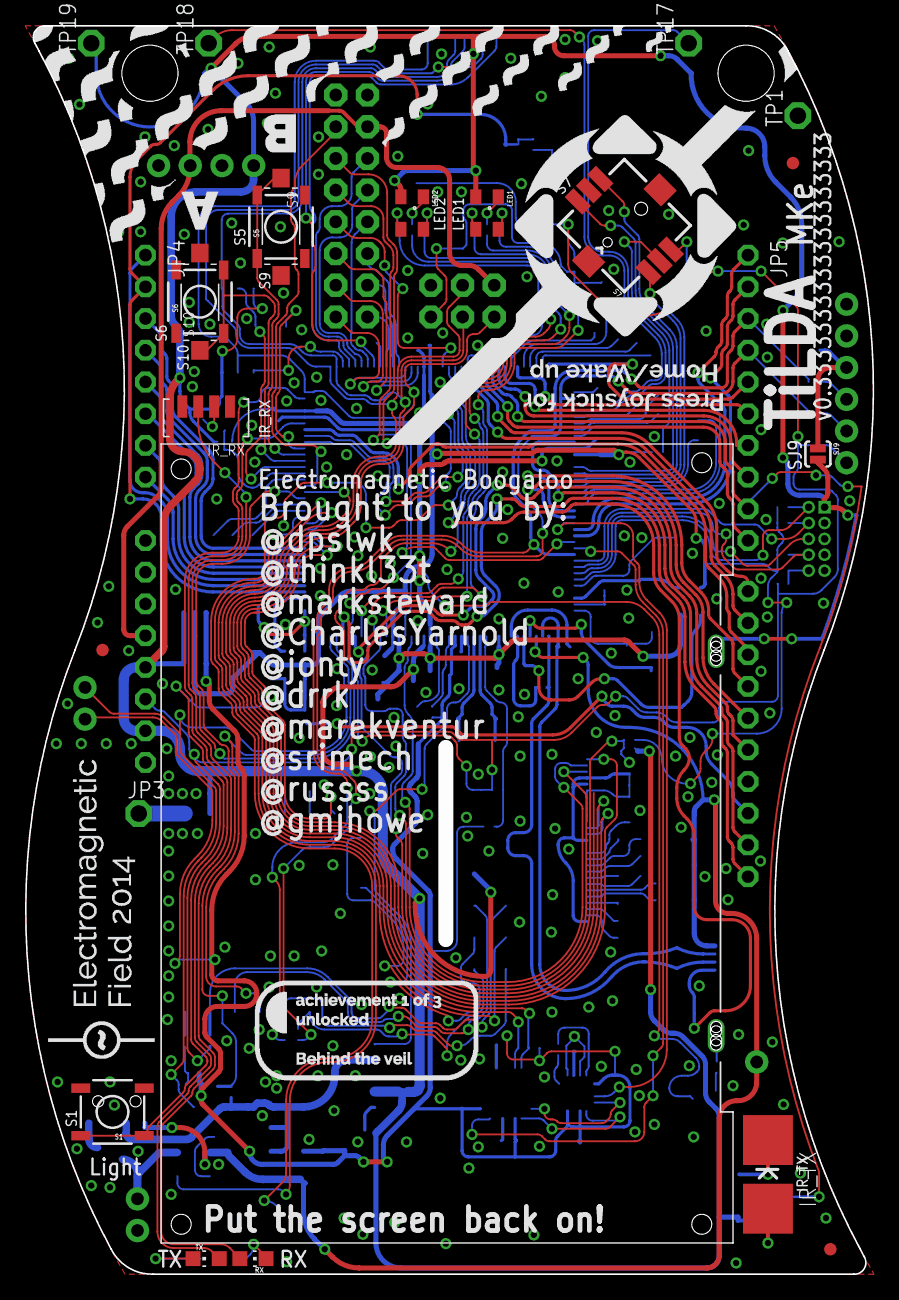
[picture p16: board TiLDA Mk2 Prototype v0.1.brd from above]

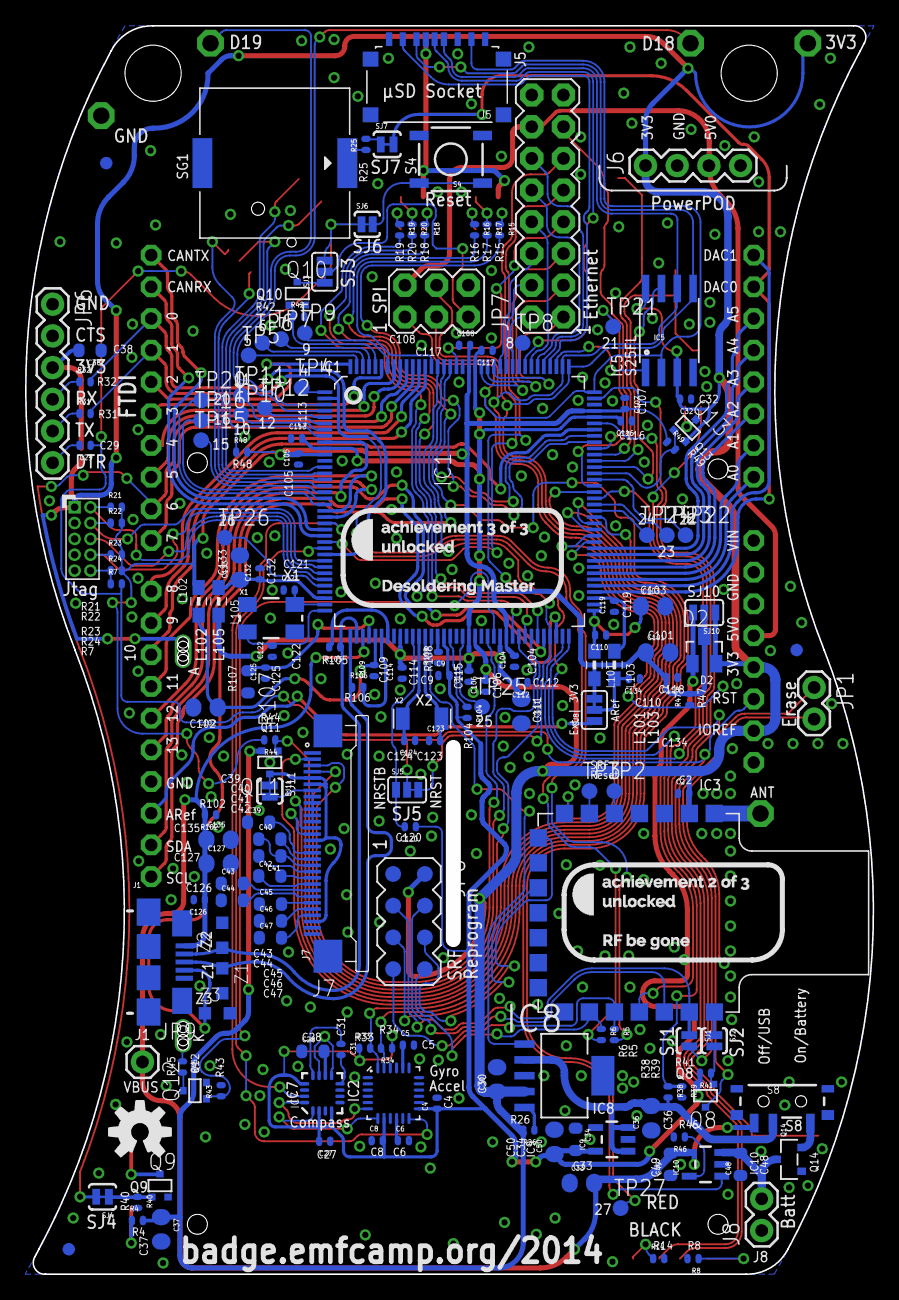
[picture p17: board TiLDA Mk2 Prototype v0.1.brd from below]

Board: 4 copper layers, 67.9 x 100.0 mm, 205 parts (177 on the bottom side), 191 nets.
