emfcamp/Mk2-Hardware/(commit log)

2013-09-05 Adding Ciseco-Eagle-Library Submodule for SRF footprint
2013-09-05 Adding Parts Library and Blank Prototype Schematic
    [TiLDA Mk2 Prototype.sch]
2013-11-16 Parts: Lots of changes, Custom EPD Zif Symbol, linked to some std connectors, Adding a load of other stuff
2013-11-16 Prototype: Working on board outline and initial layout
    [TiLDA Mk2 Prototype v0.1.brd, TiLDA Mk2 Prototype v0.1.sch, TiLDA Mk2 Prototype.brd, TiLDA Mk2 Prototype.sch]
2013-11-18 Parts: adding FCI 62684 connector footprint for EPD
2013-11-18 Prototype: working on about and wring some of the EPD support parts
    [TiLDA Mk2 Prototype v0.1.brd, TiLDA Mk2 Prototype v0.1.sch]
2013-11-20 Parts: Added Battery 55x44 Outline
2013-11-20 Parts: Adding µSD socket footprint
2013-11-20 Prototype: Rotated everything, Started tiding schematic, adding SRF wiring, add µSD footprintt, much more
    [TiLDA Mk2 Prototype v0.1.brd, TiLDA Mk2 Prototype v0.1.sch]
2013-11-20 Ciseco Footprints: Minor Updates
2013-11-20 Parts: Updating MOSFET footprints
2013-11-20 Parts: MPU Footprint, reworked QFN24 footprint
2013-11-20 Prototype: Working on MPU connections, swapped out for new footprint
    [TiLDA Mk2 Prototype v0.1.brd, TiLDA Mk2 Prototype v0.1.sch]
2013-11-21 Parts: Short pins on Arduino symbol
2013-11-23 Parts: Adding solder jumpers
2013-11-23 Prototype: Finished MPU Schematic wire up
    [TiLDA Mk2 Prototype v0.1.brd, TiLDA Mk2 Prototype v0.1.sch]
2013-11-23 Parts & Portotype: Update MPU part's to no die after reading data sheet
    [TiLDA Mk2 Prototype v0.1.brd, TiLDA Mk2 Prototype v0.1.sch]
2013-11-23 Parts: Adding posible USB AB footprint
2013-11-23 Parts & Prototype: Updating USB footprint
    [TiLDA Mk2 Prototype v0.1.brd, TiLDA Mk2 Prototype v0.1.sch]
2013-11-23 Parts & Prototype: Move Battery to ref layer
    [TiLDA Mk2 Prototype v0.1.brd, TiLDA Mk2 Prototype v0.1.sch]
2013-11-26 Prototype: Swapped Out JST, starting to add some SAM3X support parts
    [TiLDA Mk2 Prototype v0.1.brd, TiLDA Mk2 Prototype v0.1.sch]
2013-11-26 Ciseco footprints: SRF v1.2 landing update
    [TiLDA Mk2 Prototype v0.1.brd, TiLDA Mk2 Prototype v0.1.sch]
2013-11-26 Ciseco footprints: Ciseco LOGO update
    [TiLDA Mk2 Prototype v0.1.brd, TiLDA Mk2 Prototype v0.1.sch]
2013-11-26 Prototype: Lots of wiring on SAM3X
    [TiLDA Mk2 Prototype v0.1.brd, TiLDA Mk2 Prototype v0.1.sch]
2013-11-27 Prototype: Swapping out some parts moving some stuff around
    [TiLDA Mk2 Prototype v0.1.brd, TiLDA Mk2 Prototype v0.1.sch]
2013-11-27 Prototype: Lots of decoupling
    [TiLDA Mk2 Prototype v0.1.brd, TiLDA Mk2 Prototype v0.1.sch]
2013-11-27 Prototype: USB TX&RX LED's
    [TiLDA Mk2 Prototype v0.1.brd, TiLDA Mk2 Prototype v0.1.sch]
2013-11-27 Parts: Cleaning up some silk screen, adding round Cap's and Resistors from Arduino Lib
2013-12-04 Parts: Adding DCDC and Lipo Charger
2013-12-23 Parts: Added SPI EEPROM/Flash footprint, finished up Arduino SPI Footprint, adding varistor for ESD protection
2013-12-25 Parts: Updated mount hole, added http://www.patternagents.com touch pads, and tweaked for 45 version
2013-12-25 Prototype: Lots of changes, Lots of wiring up in schematic, added touch pad’s, swapped SD footprint, wire up LED’s, chosen IR LED, added reset button, moved lots of stuff around, hatched ground area 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
    [TiLDA Mk2 Prototype v0.1.brd, TiLDA Mk2 Prototype v0.1.sch]
2013-12-26 Parts: Adding Joystick and tweaked to APLS Footprint
2013-12-26 Prototype: Going back to Joystick and buttons
    [TiLDA Mk2 Prototype v0.1.brd, TiLDA Mk2 Prototype v0.1.sch]
2013-12-26 Prototype: Wired up EPD in schematic, wired up buttons in schematic, placed JTAG Header, swapped out Resistor array for singles, Added reset pin jumper
    [TiLDA Mk2 Prototype v0.1.brd, TiLDA Mk2 Prototype v0.1.sch]
2013-12-27 Prototype: Moving some signals around and wiring up a load more devices
    [TiLDA Mk2 Prototype v0.1.brd, TiLDA Mk2 Prototype v0.1.sch]
2013-12-27 Prototype: Adding FET to ISP RESET pin
    [TiLDA Mk2 Prototype v0.1.brd, TiLDA Mk2 Prototype v0.1.sch]
2013-12-27 Parts: Adding Fuse footprint from rcl
2013-12-28 Parts: Piezo PKLCS1212E footprint
2013-12-28 Prototype: Update buzzer, looking at moving USB to side (shorter tracks)
    [TiLDA Mk2 Prototype v0.1.brd, TiLDA Mk2 Prototype v0.1.sch]
2013-12-29 Parts: Adding PMIC, FET, Inductors for FAN5404x
2013-12-29 Prototype: Trying FAN5404x PMIC
    [TiLDA Mk2 Prototype v0.1.brd, TiLDA Mk2 Prototype v0.1.sch]
2013-12-30 Parts: Adding MCP1825T regulator
2013-12-30 Prototype: Adding MCP1825T as 3V3 reg, adding and trying LTC4160 PMIC
    [TiLDA Mk2 Prototype v0.1.brd, TiLDA Mk2 Prototype v0.1.sch]
2013-12-30 Prototype: Swapping signals to get wakeup pins
    [TiLDA Mk2 Prototype v0.1.brd, TiLDA Mk2 Prototype v0.1.sch]
2013-12-30 Ciseco footprints: Updating to pull in Power-POD Landings
2013-12-31 Prototype: Adding optional HM5883L Compass footprint. Swapping Ethernet header to match the Tanijino one, should then be able to use there modules, had to move RGB LED’s out for Eth Header
    [TiLDA Mk2 Prototype v0.1.brd, TiLDA Mk2 Prototype v0.1.sch]
2013-12-31 Prototype: Started wiring up in board, lots todo still
    [TiLDA Mk2 Prototype v0.1.brd, TiLDA Mk2 Prototype v0.1.sch]
2013-12-31 Prototype: More wiring, Stash before moving Reset button
    [TiLDA Mk2 Prototype v0.1.brd]
2013-12-31 Prototype: Reset and JTAG move around
    [TiLDA Mk2 Prototype v0.1.brd, TiLDA Mk2 Prototype v0.1.sch]
2014-01-01 Prototype: Wiring up, Stash before remove FAN5404X PMIC
    [TiLDA Mk2 Prototype v0.1.brd, TiLDA Mk2 Prototype v0.1.sch]
2014-01-01 Parts: Schematic Footprint updates
2014-01-01 Prototype: Bunch more wiring, PMIC now in place, Lots of schematic tidying.
    [TiLDA Mk2 Prototype v0.1.brd, TiLDA Mk2 Prototype v0.1.sch]
2014-01-01 Parts: Adding AT45DB data flash footprints, tweaked some others
2014-01-01 Prototype: Adding alternative SPI FLASH chip and foot print.
    [TiLDA Mk2 Prototype v0.1.brd, TiLDA Mk2 Prototype v0.1.sch]
2014-01-01 Prototype: Wired up the SPI Flash and SD socket
    [TiLDA Mk2 Prototype v0.1.brd, TiLDA Mk2 Prototype v0.1.sch]
2014-01-01 Prototpye: JTAG header wired.
    [TiLDA Mk2 Prototype v0.1.brd]
2014-01-02 Prototype: More wiring bring signals up from the lower half
    [TiLDA Mk2 Prototype v0.1.brd, TiLDA Mk2 Prototype v0.1.sch]
2014-01-02 Prototype: USB Data pair routed and length matched
    [TiLDA Mk2 Prototype v0.1.brd, TiLDA Mk2 Prototype v0.1.sch]
2014-01-02 Prototype Buzzer disconnect jumper
    [TiLDA Mk2 Prototype v0.1.brd, TiLDA Mk2 Prototype v0.1.sch]
2014-01-02 Prototype: Adding I2C pull-up’s
    [TiLDA Mk2 Prototype v0.1.brd, TiLDA Mk2 Prototype v0.1.sch]
2014-01-02 Prototype: Reworked USB Traces, tweaked some other bits
    [TiLDA Mk2 Prototype v0.1.brd, TiLDA Mk2 Prototype v0.1.sch]
2014-01-02 Parts: Reworking IMU Footprints
2014-01-02 Prototype: Updating IMU Footprints,
    [TiLDA Mk2 Prototype v0.1.brd, TiLDA Mk2 Prototype v0.1.sch]
2014-01-02 Prototype: Swapping MPU_INT onto a wake up pin
    [TiLDA Mk2 Prototype v0.1.brd, TiLDA Mk2 Prototype v0.1.sch]
2014-01-02 Prototype: Adding Pull-Up’s for PMIC output lines
    [TiLDA Mk2 Prototype v0.1.brd, TiLDA Mk2 Prototype v0.1.sch]
2014-01-02 Prototype: More wiring
    [TiLDA Mk2 Prototype v0.1.brd, TiLDA Mk2 Prototype v0.1.sch]
2014-01-03 Prototype: Adding a PD to monitor Batter Voltage
    [TiLDA Mk2 Prototype v0.1.brd, TiLDA Mk2 Prototype v0.1.sch]
2014-01-03 Prototype: Assigned the last of the Pins, PMIC and HMC
    [TiLDA Mk2 Prototype v0.1.brd, TiLDA Mk2 Prototype v0.1.sch]
2014-01-03 Prototype: Lots of wiring up, adding Test Pad’s for unused pins
    [TiLDA Mk2 Prototype v0.1.brd, TiLDA Mk2 Prototype v0.1.sch]
2014-01-04 Prototype: Lots more wiring up, swapped PMIC ILIM signals, moving some other stuff around
    [TiLDA Mk2 Prototype v0.1.brd, TiLDA Mk2 Prototype v0.1.sch]
2014-01-04 Prototype: More wiring, FWUP pull-up to VBACKUP
    [TiLDA Mk2 Prototype v0.1.brd, TiLDA Mk2 Prototype v0.1.sch]
2014-01-04 Prototype: Wiring done!!!
    [TiLDA Mk2 Prototype v0.1.brd, TiLDA Mk2 Prototype v0.1.sch]
2014-01-04 Prototype: Adding name and version to Silk
    [TiLDA Mk2 Prototype v0.1.brd]
2014-01-04 Grebers: Adding prototype v0.1
2014-01-04 PDF: Schematic for v0.1
2014-01-05 Parts: Creating EMF Power-POD landing (Custom Silk) Prototype: Updating Power-POD landing
    [TiLDA Mk2 Prototype v0.1.brd, TiLDA Mk2 Prototype v0.1.sch]
2014-01-05 Parts: Update USB AB Schematic footprint Prototype: Lots of Silkscreen changes, added part placement labels Gerbers: Updated for changes Parts List: Adding txt export of parts list
    [TiLDA Mk2 Prototype v0.1.brd, TiLDA Mk2 Prototype v0.1.sch, TiLDA Mk2 Prototype.brd, TiLDA Mk2 Prototype.sch]
2014-01-08 Parts: Update Lipo Connector silk
2014-01-08 Parts: Adding slide switch
2014-01-08 Prototype: Adding slide switch
    [TiLDA Mk2 Prototype v0.1.brd, TiLDA Mk2 Prototype v0.1.sch]
2014-01-10 Prototype: Adding conductive thread pad’s, moving fid’s around, tidy some other bits
    [TiLDA Mk2 Prototype v0.1.brd, TiLDA Mk2 Prototype v0.1.sch]
2014-01-10 Gerbers: Update to latest
2014-01-11 Parts: Adding alterative µSD socket
2014-01-11 Prototype: New SD Socket in place, adding extra land yard hold, lots to fix up
    [TiLDA Mk2 Prototype v0.1.brd, TiLDA Mk2 Prototype v0.1.sch]
2014-01-11 Prototype: Correct µSD socket value
    [TiLDA Mk2 Prototype v0.1.brd, TiLDA Mk2 Prototype v0.1.sch]
2014-01-11 Prototype: Finish off rework to fit two holes tidy up some other traces. Parts: New 4.5mm hole with no silk
    [TiLDA Mk2 Prototype v0.1.brd, TiLDA Mk2 Prototype v0.1.sch]
2014-01-11 Prototype: Trace tweak
    [TiLDA Mk2 Prototype v0.1.brd]
2014-01-12 Parts: restore TILDA outline device, New Battery outlines
2014-01-12 Prototype: Lots of cleaning up, part values, few tracks, Added decoupling for IR TX and FTDI
    [TiLDA Mk2 Prototype v0.1.brd, TiLDA Mk2 Prototype v0.1.sch]
2014-01-12 Prototype: swap C30 & C35 for 0805
    [TiLDA Mk2 Prototype v0.1.brd, TiLDA Mk2 Prototype v0.1.sch]
2014-01-12 Prototype: C34, C38 to 10v, C21, C24, C25 to 0603 X5R
    [TiLDA Mk2 Prototype v0.1.brd, TiLDA Mk2 Prototype v0.1.sch]
2014-01-12 Prototype: Move C120 to NTRSB and VBackup
    [TiLDA Mk2 Prototype v0.1.brd, TiLDA Mk2 Prototype v0.1.sch]
2014-01-12 Prototype: Update for bigger X1 Crystal
    [TiLDA Mk2 Prototype v0.1.brd, TiLDA Mk2 Prototype v0.1.sch]
2014-01-12 Prototype: Part Value updates Gerbers: update to latest PDF: update to latest
    [TiLDA Mk2 Prototype v0.1.brd, TiLDA Mk2 Prototype v0.1.sch]
2014-01-12 Prototype: FTDI Power Jumper
    [TiLDA Mk2 Prototype v0.1.brd, TiLDA Mk2 Prototype v0.1.sch]
2014-01-14 Prototype: Corrected Joystick pins
    [TiLDA Mk2 Prototype v0.1.brd, TiLDA Mk2 Prototype v0.1.sch]
2014-01-14 Parts: Tweak buzzer footprint Prototype: Update buzzer footprint and move res to fit
    [TiLDA Mk2 Prototype v0.1.brd, TiLDA Mk2 Prototype v0.1.sch]
2014-01-16 Gerbers: Final v0.1 prototype version as sent to ragworm
    [TiLDA Mk2 Prototype v0.1.brd]
2014-01-16 Adding DRC and CAM rules Gerbers: updated file name extensions to work with gerblook.org
    [bottom_copper_TiLDA Mk2 Prototype v0.1.GBL, bottom_cream_TiLDA Mk2 Prototype v0.1.GBP, bottom_silkscreen_TiLDA Mk2 Prototype v0.1.GBO, bottom_soldermask_TiLDA Mk2 Prototype v0.1.GBS, dimension_TiLDA Mk2 Prototype v0.1.GKO, drills_TiLDA Mk2 Prototype v0.1.XLN, top_copper_TiLDA Mk2 Prototype v0.1.GTL, top_cream_TiLDA Mk2 Prototype v0.1.GTP]
2014-01-21 Prototype: Minor Trace tweak
    [TiLDA Mk2 Prototype v0.1.brd]
2014-02-08 Prototype: Adding Pull up/down resistors to FET’s, Schematic only for now
    [TiLDA Mk2 Prototype v0.1.brd, TiLDA Mk2 Prototype v0.1.sch]
2014-02-08 Prototype: move resistor near target locations
    [TiLDA Mk2 Prototype v0.1.brd]
2014-02-08 Prototype: Adding IR_RX_PWR MOSFET and resistor parts
    [TiLDA Mk2 Prototype v0.1.brd, TiLDA Mk2 Prototype v0.1.sch]
2014-02-16 Prototype: Move pin 1 SPI silk
    [TiLDA Mk2 Prototype v0.1.brd]
2014-03-29 Prototype: Fitting some of the pull up's
    [TiLDA Mk2 Prototype v0.1.brd]
2014-04-27 ProPrototype: More pull up's and FET for IR_RX
    [TiLDA Mk2 Prototype v0.1.brd]
2014-06-28 Prototype: Remove JST socket, throw in 2 pin, add LCD reference,
    [TiLDA Mk2 Prototype v0.1.brd, TiLDA Mk2 Prototype v0.1.sch]
2014-06-28 Prototype: Remove ePaper parts and outline
    [TiLDA Mk2 Prototype v0.1.brd, TiLDA Mk2 Prototype v0.1.sch]
2014-06-28 Prototype: remove LPS4018 PMIC
    [TiLDA Mk2 Prototype v0.1.brd, TiLDA Mk2 Prototype v0.1.sch]
2014-06-28 Parts: SFV30R-2STE1HLF connector for LCD
2014-06-28 Prototype: move out USB and IMU, adding in LCD and wiring up cap's
    [TiLDA Mk2 Prototype v0.1.brd, TiLDA Mk2 Prototype v0.1.sch]
2014-06-28 Prototype: update caps to 0805 foot print to get some space back
    [TiLDA Mk2 Prototype v0.1.brd, TiLDA Mk2 Prototype v0.1.sch]
2014-06-28 Prototype: It fits!! lcd slot and connector in place and lots of traces moved around
    [TiLDA Mk2 Prototype v0.1.brd, TiLDA Mk2 Prototype v0.1.sch]
2014-06-29 Parts: adding new tac switch
2014-07-05 Quick LCD breakout for new LCD
    [TiLDA Mk2 LCD Breakout v0.1.brd, TiLDA Mk2 LCD Breakout v0.1.sch]
2014-07-05 Prototype: Lots of changes
    [TiLDA Mk2 Prototype v0.1.brd, TiLDA Mk2 Prototype v0.1.sch]
2014-07-05 Parts: Tac switch silk tweak
2014-07-05 Prototype: More wiring up. moved IR_RX around, lost PowerPOD
    [TiLDA Mk2 Prototype v0.1.brd, TiLDA Mk2 Prototype v0.1.sch]
2014-07-06 Prototype: Lots more wiring done, IMU reconnected, just LCD left
    [TiLDA Mk2 Prototype v0.1.brd, TiLDA Mk2 Prototype v0.1.sch]
2014-07-06 Prototype: Finished rewire
    [TiLDA Mk2 Prototype v0.1.brd, TiLDA Mk2 Prototype v0.1.sch]
2014-07-07 Prototype: Last tweak for v0.2, adding SJ for VDDIO between 3V3 and VBACKUP
    [TiLDA Mk2 Prototype v0.1.brd, TiLDA Mk2 Prototype v0.1.sch]
2014-07-07 Prototype: Moved silk screen back over
    [TiLDA Mk2 Prototype v0.1.brd]
2014-07-07 Gerbers: v0.2
    [bottom_copper_TiLDA Mk2 Prototype v0.1.GBL, bottom_cream_TiLDA Mk2 Prototype v0.1.GBP, bottom_silkscreen_TiLDA Mk2 Prototype v0.1.GBO, bottom_soldermask_TiLDA Mk2 Prototype v0.1.GBS, dimension_TiLDA Mk2 Prototype v0.1.GKO, drills_TiLDA Mk2 Prototype v0.1.XLN, top_copper_TiLDA Mk2 Prototype v0.1.GTL, top_cream_TiLDA Mk2 Prototype v0.1.GTP]
2014-07-07 Gerbers: Archive for v0.2
2014-07-10 Parts: Miter corner board Prototype: Miter corner board
    [TiLDA Mk2 Prototype v0.1.brd, TiLDA Mk2 Prototype v0.1.sch]
2014-07-10 Prototype: Slik screen updates
    [TiLDA Mk2 Prototype v0.1.brd, TiLDA Mk2 Prototype v0.1.sch]
2014-07-10 Prototype: moved SRF reprogram to the bottom, more silk screen tweaks
    [TiLDA Mk2 Prototype v0.1.brd, TiLDA Mk2 Prototype v0.1.sch]
2014-07-12 Parts: correct LCD FPC and outline footprints
2014-07-13 Prototype: fixed LCD conections
    [TiLDA Mk2 Prototype v0.1.brd, TiLDA Mk2 Prototype v0.1.sch]
2014-07-13 Prototype: Typo
    [TiLDA Mk2 Prototype v0.1.brd]
2014-07-15 Prototype: Curve all the tracks
    [TiLDA Mk2 Prototype v0.1.brd]
2014-07-16 Prototype: more curves
    [TiLDA Mk2 Prototype v0.1.brd, TiLDA Mk2 Prototype v0.1.sch]
2014-07-16 Prototype: Allow power from just USB
    [TiLDA Mk2 Prototype v0.1.brd, TiLDA Mk2 Prototype v0.1.sch]
2014-07-16 Prototype: Even more curves
    [TiLDA Mk2 Prototype v0.1.brd]
2014-07-16 Prototype : Flipped IR_RX around for easier hand soldering
    [TiLDA Mk2 Prototype v0.1.brd]
2014-07-17 Prototype: Tweaks
    [TiLDA Mk2 Prototype v0.1.brd]
2014-07-17 Parts: Joystick footprint Prototype: Joystick footprint
    [TiLDA Mk2 Prototype v0.1.brd, TiLDA Mk2 Prototype v0.1.sch]
2014-07-17 Parts: Fix LCD footprint Prototype: Correct tracks fro LCD Footprint
    [TiLDA Mk2 Prototype v0.1.brd, TiLDA Mk2 Prototype v0.1.sch]
2014-07-17 Prototype: 0805 LED's
    [TiLDA Mk2 Prototype v0.1.brd, TiLDA Mk2 Prototype v0.1.sch]
2014-07-18 Prototype: Minor tweaks, adding TP27, moved L102, L105
    [TiLDA Mk2 Prototype v0.1.brd, TiLDA Mk2 Prototype v0.1.sch]
2014-07-19 Prototype: Get backlight onto a PWM, swapped LCD_BACKLIGHT and TP25.
    [TiLDA Mk2 Prototype v0.1.brd, TiLDA Mk2 Prototype v0.1.sch]
2014-07-19 Prototype: Get LIGHT on to a wake up pin, swapped LIGTH with AT_COMMAND
    [TiLDA Mk2 Prototype v0.1.brd, TiLDA Mk2 Prototype v0.1.sch]
2014-07-19 Prototype: Artwork and trace tweak
    [TiLDA Mk2 Prototype v0.1.brd]
2014-07-20 Prototype: VDDIO rewire
    [TiLDA Mk2 Prototype v0.1.brd, TiLDA Mk2 Prototype v0.1.sch]
2014-07-20 Prototype: Reverser polarity protection
    [TiLDA Mk2 Prototype v0.1.brd, TiLDA Mk2 Prototype v0.1.sch]
2014-07-20 PDF: Add missing v0.2 schematic
2014-07-20 Prototype: Minor schematic tweaks, board tweaks
    [TiLDA Mk2 Prototype v0.1.brd, TiLDA Mk2 Prototype v0.1.sch]
2014-07-20 Prototype: Adding pull up to LCD D0-D5 via SJ11
    [TiLDA Mk2 Prototype v0.1.brd, TiLDA Mk2 Prototype v0.1.sch]
2014-07-20 Prototype: Last few curved traces
    [TiLDA Mk2 Prototype v0.1.brd, TiLDA Mk2 Prototype v0.1.sch]
2014-07-20 Parts and Prototype: Final artwork
    [TiLDA Mk2 Prototype v0.1.brd, TiLDA Mk2 Prototype v0.1.sch]
2014-07-20 Gerbers: Artwork
    [bottom_copper_TiLDA Mk2 Prototype v0.1.GBL, bottom_silkscreen_TiLDA Mk2 Prototype v0.1.GBO, top_copper_TiLDA Mk2 Prototype v0.1.GTL, top_silkscreen_TiLDA Mk2 Prototype v0.1.GTO]
2014-07-21 Parts and Prototype: Adding BAT54C to VDDIO
    [TiLDA Mk2 Prototype v0.1.brd, TiLDA Mk2 Prototype v0.1.sch]
2014-07-21 Gerbers: Updated
    [bottom_copper_TiLDA Mk2 Prototype v0.1.GBL, bottom_cream_TiLDA Mk2 Prototype v0.1.GBP, bottom_silkscreen_TiLDA Mk2 Prototype v0.1.GBO, bottom_soldermask_TiLDA Mk2 Prototype v0.1.GBS, top_copper_TiLDA Mk2 Prototype v0.1.GTL]
2014-07-21 Prototype: Correct Schematic Merge
    [TiLDA Mk2 Prototype v0.1.sch]
2014-07-21 PDF, Gerbers: Updated
    [TiLDA Mk2 Prototype v0.1.brd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]
2014-07-21 All: Last tweak to add VBus pad for OTG stuff
    [TiLDA Mk2 Prototype v0.1.brd, TiLDA Mk2 Prototype v0.1.sch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]
2014-07-31 Gerbers: Tweak to correct top stencil
    [top_cream_TiLDA Mk2 Prototype v0.1.GTP]
2014-08-12 Parts: Updating MOSFET SOT23 footprints for next time
2014-11-05 Parts: Updating USB-AB to split GND and Shield pins
2014-11-06 Parts: Adding SOT523 to MOSFET-N
2015-05-12 Parts: IR footprint for both TT and TR
2015-05-12 PDF: renames and mount data
    [TiLDA Mk2 Prototype v0.1.mnb.csv, TiLDA Mk2 Prototype v0.1.mnt.csv]
2015-05-12 Parts: prototype headers
2015-05-12 ProtoShield: First Commit
    [TiLDA Mk2 ProtoShield v0.1.brd, TiLDA Mk2 ProtoShield v0.1.sch]
2015-05-13 ProtoShield: lots more work
    [TiLDA Mk2 ProtoShield v0.1.brd, TiLDA Mk2 ProtoShield v0.1.sch]
